joysfera/SDrive/HW/FUSES.GIF

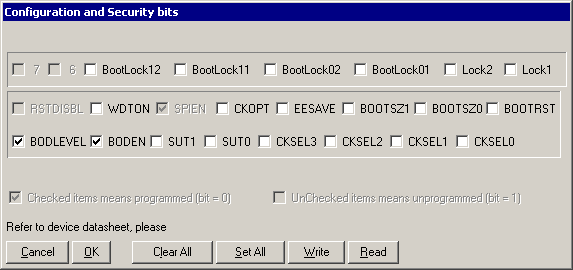
HW/FUSES.GIF
