joysfera/SDrive/HW/SDRIVE_AVR_PROGRAMMING_CABLE.PNG

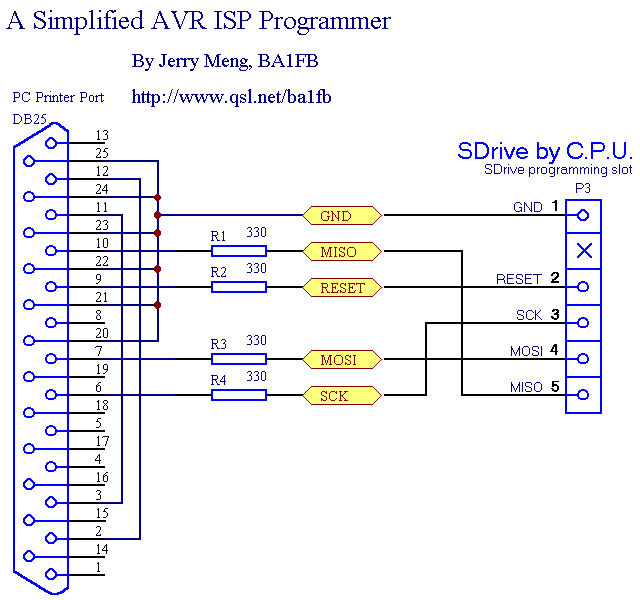
HW/SDRIVE_AVR_PROGRAMMING_CABLE.PNG
