joysfera/SDrive/HW/SILKSCREEN_PADS.PNG

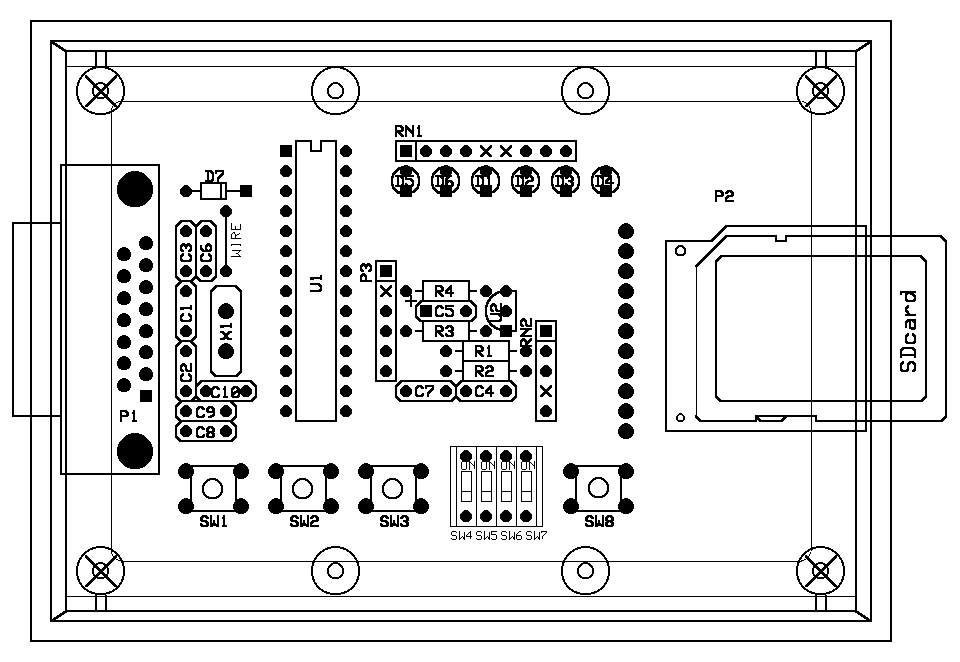
HW/SILKSCREEN_PADS.PNG
