joysfera/SDrive/HW/PCB_COMPONENTS.PNG

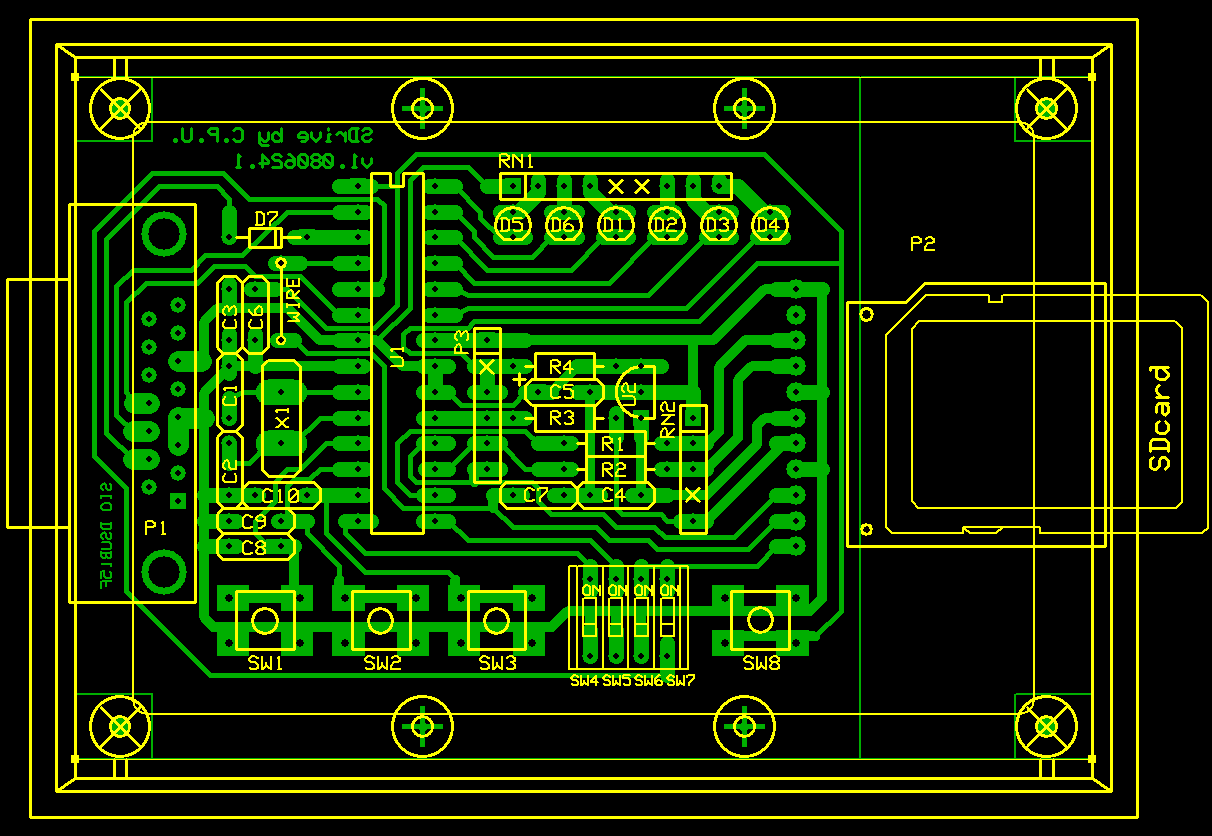
HW/PCB_COMPONENTS.PNG
