joysfera/SDrive/HW/PCB_COMPONENTS.PDF

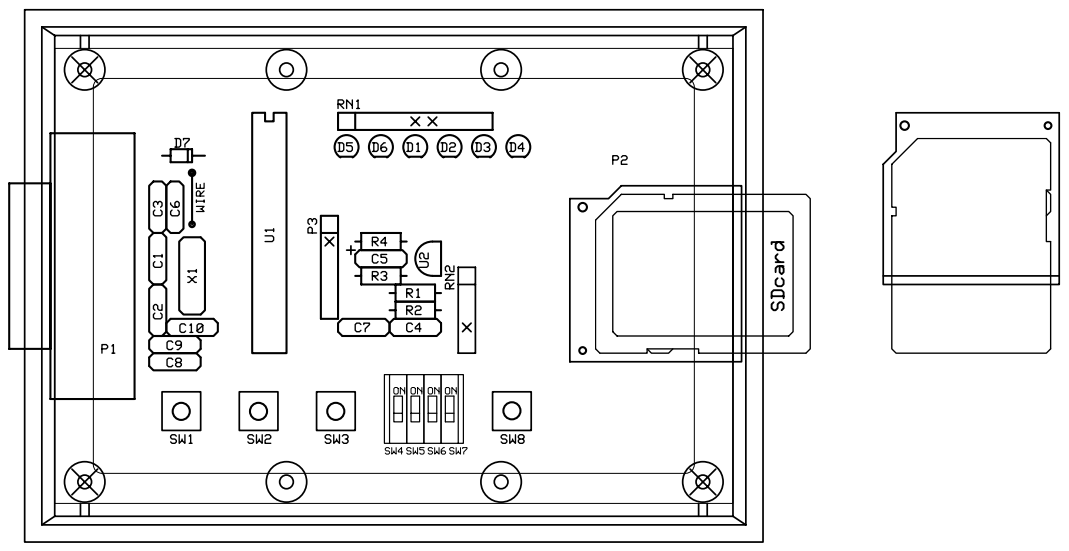
[picture p9: page 1]
