joysfera/SDrive/HW/ELEMENTS.PDF

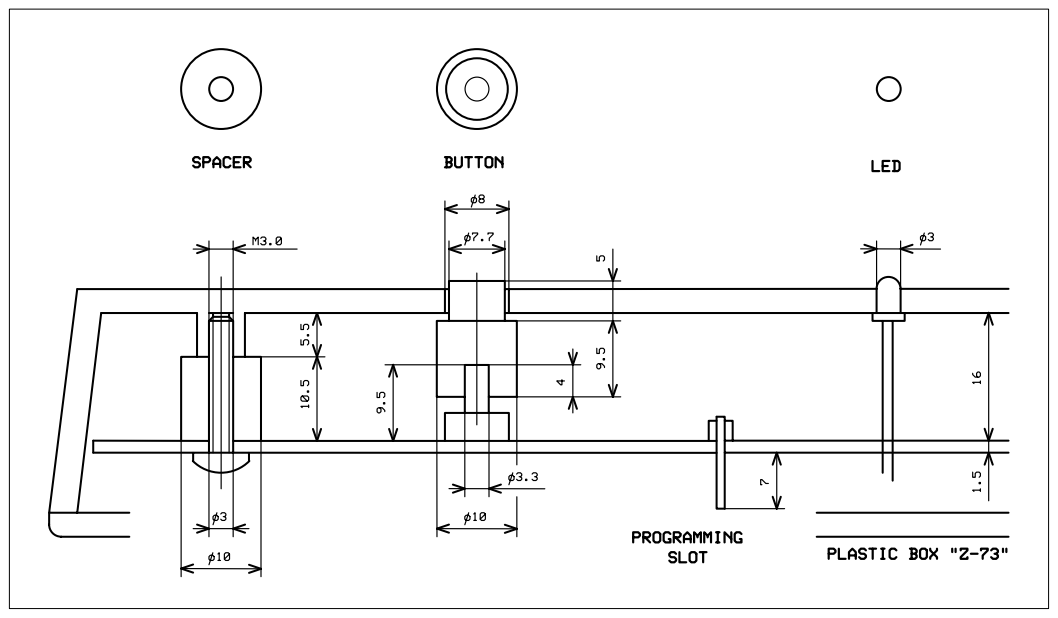
[picture p10: page 1]
