joysfera/SDrive/HW/PCB.PDF

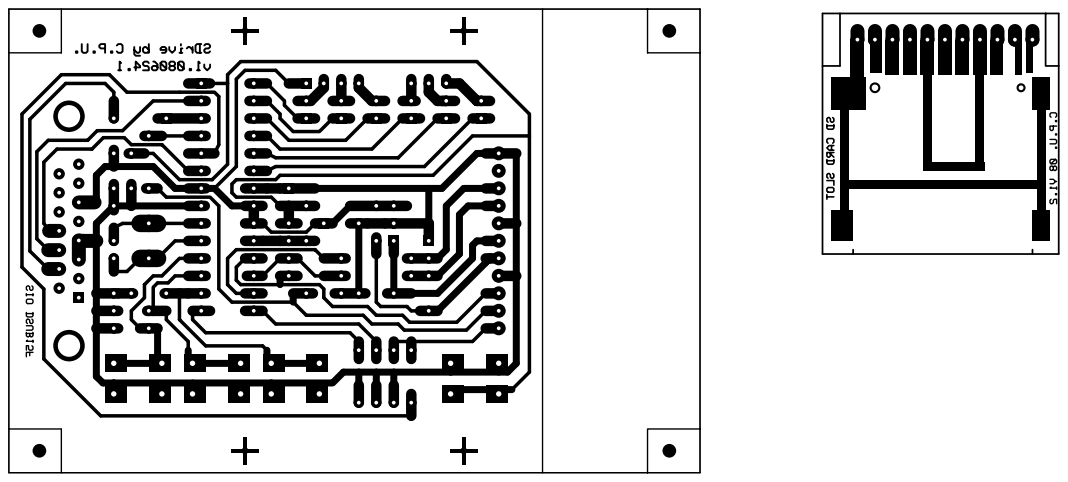
[picture p11: page 1]
