joysfera/SDrive/HW/PCB_NEGATIVE.PDF

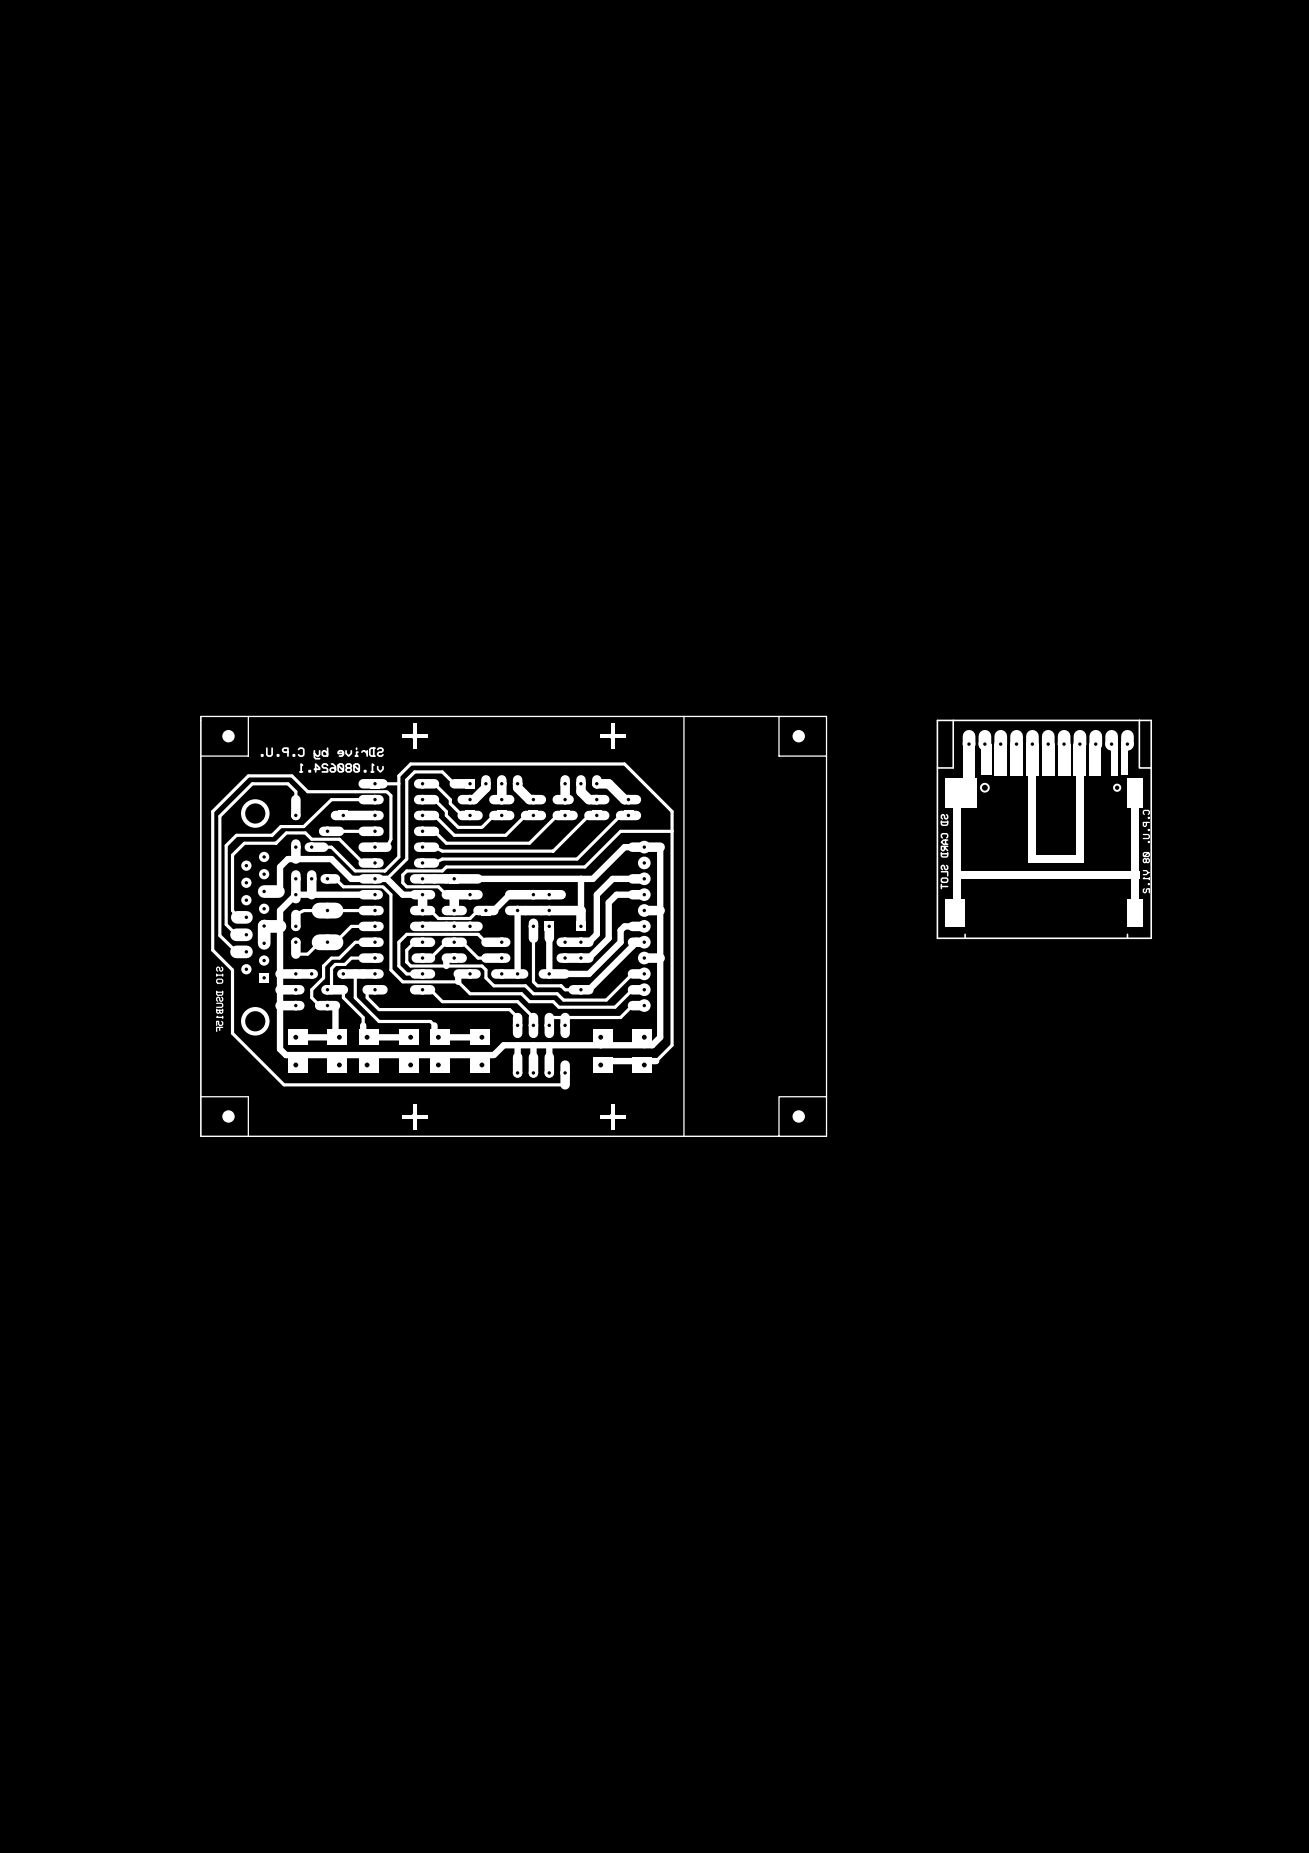
[picture p12: page 1]
