joysfera/SDrive/HW/SCHEME.PDF

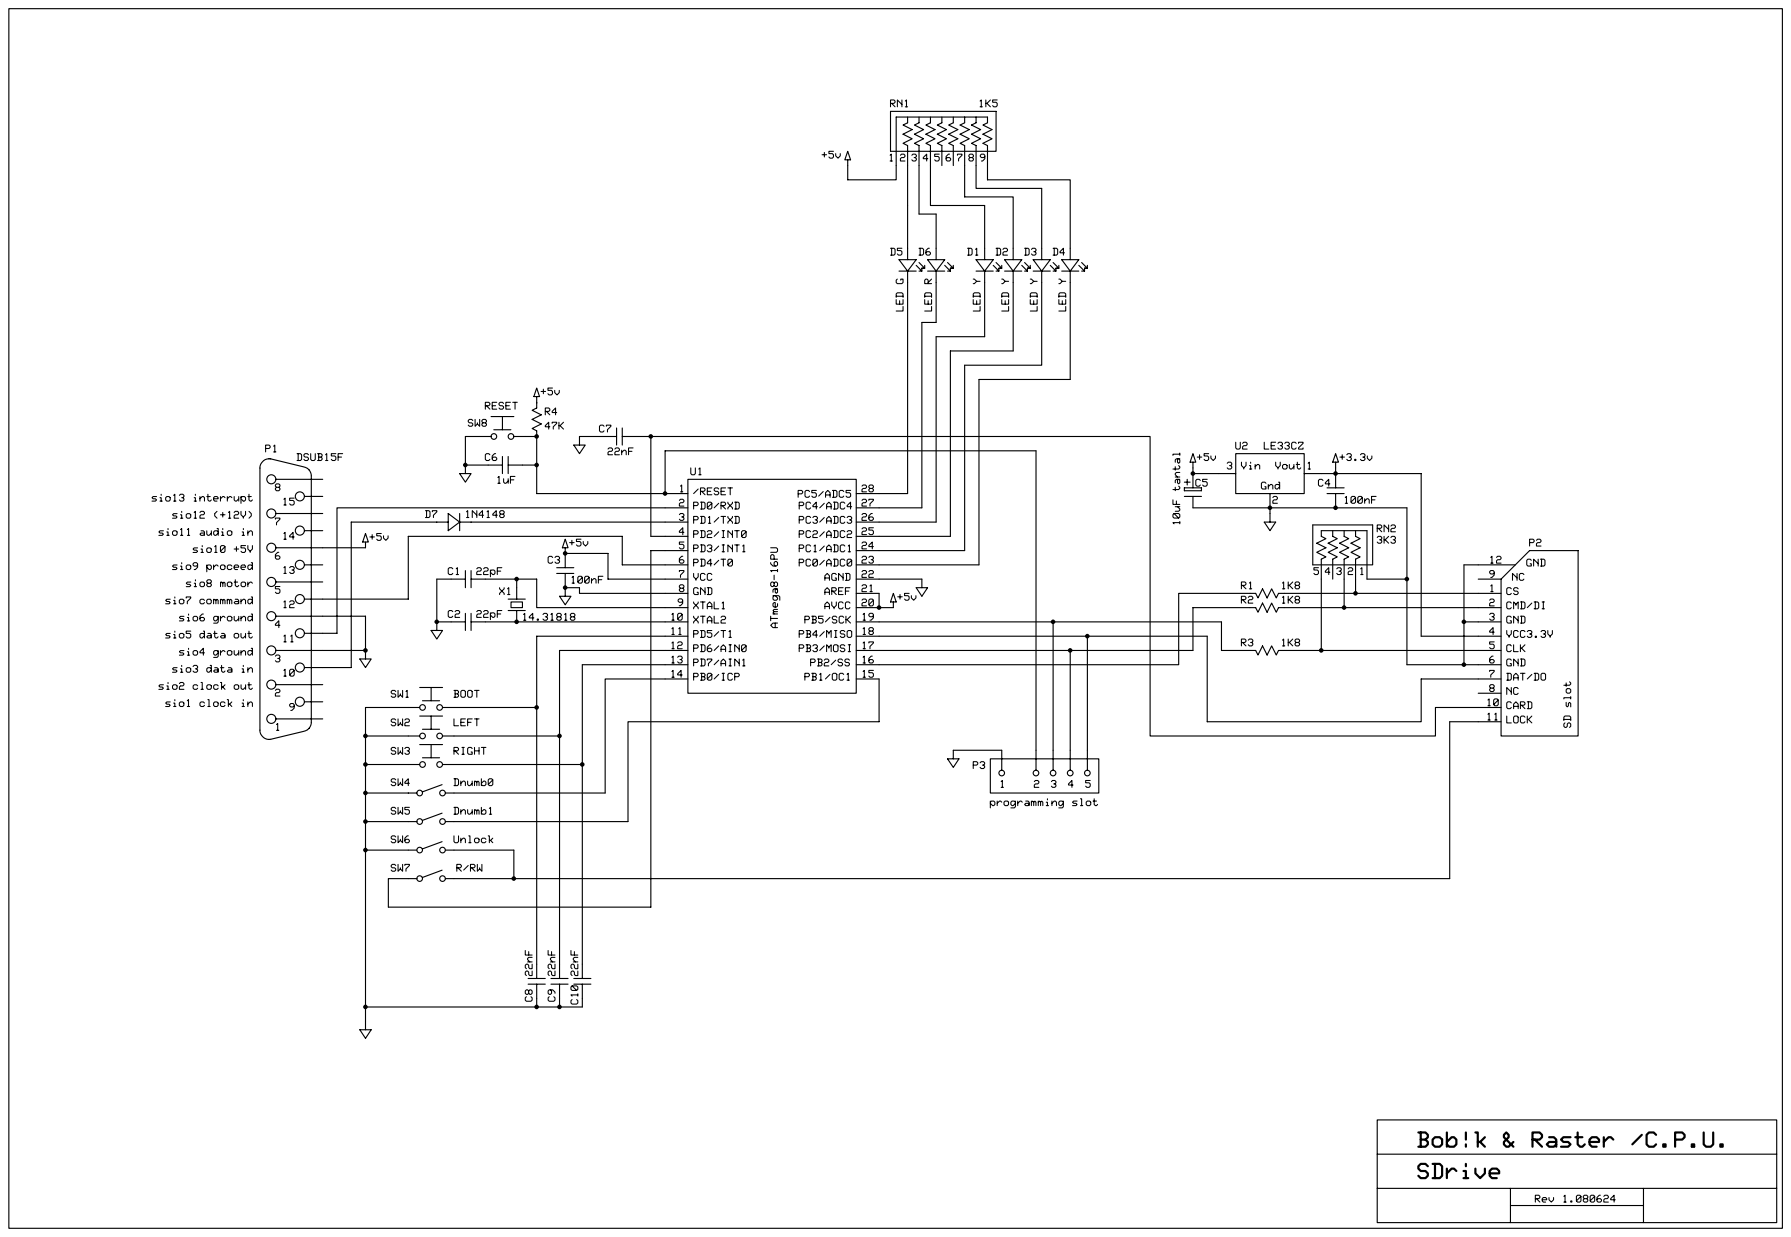
[picture p13: page 1]
