joysfera/SDrive/HW/SDRIVE_LABEL.PDF

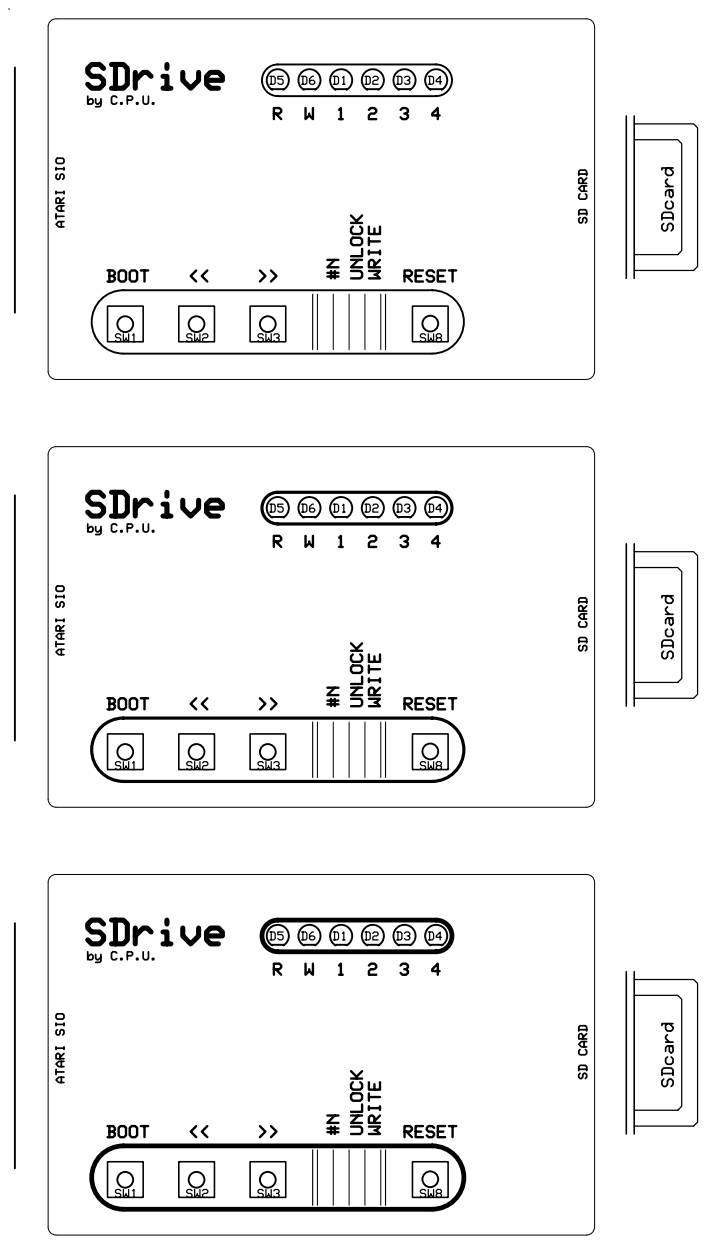
[picture p14: page 1]
