joysfera/SDrive/SDrive.c

//*****************************************************************************
// SDrive
// Bob!k & Raster, C.P.U., 2008-2012
//*****************************************************************************

#include <avr/io.h>			// include I/O definitions (port names, pin names, etc)
#include <avr/interrupt.h>	// include interrupt support
#include <avr/pgmspace.h>

#include <avr/eeprom.h>

#include "avrlibdefs.h"			// global AVRLIB defines
#include "avrlibtypes.h"		// global AVRLIB types definitions
#include "spi.h"		// include SPI interface functions
#include "mmc.h"		// include MMC card access functions
#include "fat.h"
#include "sboot.h"

#define DEBUG_RAM 		0	//0=off, 1=on

#define    TWOBYTESTOWORD(ptr)           *((u16*)(ptr))
#define    FOURBYTESTOLONG(ptr)           *((u32*)(ptr))


extern void Delay100usX(unsigned short delay);        //externi funkce
extern void Delay100us();
extern void Delay200us();
extern void Delay800us();
extern void Delay1000us();

//F_CPU = 14318180
//UBRR = (F_CPU/16/BAUD)-1
//BAUD = (F_CPU/16/(UBRR+1)
//Pokey_frq = 1789790
//BAUD = Pokey_frq/2/(AUDF+7)		//(16bit register)

#define US_POKEY_DIV_STANDARD	0x28		//#40  => 19040 bps
#define ATARI_SPEED_STANDARD	(US_POKEY_DIV_STANDARD+6)	//#46 (o sest vic)

#define US_POKEY_DIV_DEFAULT	0x06		//#6   => 68838 bps

#define US_POKEY_DIV_MAX		(255-6)		//pokeydiv 249 => avrspeed 255 (vic nemuze)

/*
#define SIOSPEED_MODES	9	//pocet fastsio_mode=0..8
#define US_POKEY_DIV_DEFAULT	US_POKEY_DIV_7
#define ATARI_SPEED_DEFAULT		ATARI_SPEED_7

//sio 1x standard
#define US_POKEY_DIV_STANDARD	0x28		//=> 19040 bps
#define ATARI_SPEED_STANDARD	46			// normal speed
//=46 => F_CPU/16/(46+1) = 19040

//sio2x
#define US_POKEY_DIV_2		0x10			//=> 38908 bps
#define ATARI_SPEED_2		22				// sio2x speed
//=22 => F_CPU/16/(22+1) = 38908

//Happy
#define US_POKEY_DIV_3		0x0a			//=> 52641 bps
#define ATARI_SPEED_3		16				// happy
//=16 => F_CPU/16/(16+1) = 52640

//Speedy
#define US_POKEY_DIV_4		0x09		//=> 55931 bps
#define ATARI_SPEED_4		15			// speedy TOTO FUNGUJE
//=15 => F_CPU/16/(15+1) = 55930

//sio3x
#define US_POKEY_DIV_5		0x08			//=> 59660 bps
#define ATARI_SPEED_5		14				// sio3x speed
//=14 => F_CPU/16/(14+1) = 59659

//sio 64000
#define US_POKEY_DIV_6		0x07			//=> 63921 bps
#define ATARI_SPEED_6		13				// sio3x speed
//=13 => F_CPU/16/(13+1) = 63920

// works great!
#define US_POKEY_DIV_7		0x06			//=> 68838 bps
#define ATARI_SPEED_7		12				// ULTRA speed - closest match for both systems (AVR,ATARI)
//=12 => F_CPU/16/(12+1) = 68837

//sio 75000
#define US_POKEY_DIV_8		0x05			//=> 74575 bps
#define ATARI_SPEED_8		11				// sio4x speed
//=11 => F_CPU/16/(11+1) = 74574
*/

#define FILE_ACCESS_READ	0
#define FILE_ACCESS_WRITE	1

// Aktivita
#define LED_GREEN_ON	cbi(PORTC,5)
#define LED_GREEN_OFF	sbi(PORTC,5)
// Zapis
#define LED_RED_ON		cbi(PORTC,4)
#define LED_RED_OFF		sbi(PORTC,4)

unsigned char mmc_sector_buffer[512];	// one SD sector
u32 n_actual_mmc_sector;
unsigned char n_actual_mmc_sector_needswrite;
unsigned char atari_sector_buffer[256];

#define FileFindBuffer (atari_sector_buffer+256-11)		//pri vyhledavani podle nazvu

struct GlobalSystemValues GS;
struct FileInfoStruct FileInfo;			//< file information for last file accessed

extern u32 debug_endofvariables;

#define send_ACK()	USART_Transmit_Byte('A');
#define send_NACK()	USART_Transmit_Byte('N');
#define send_CMPL()	USART_Transmit_Byte('C');
#define send_ERR()	USART_Transmit_Byte('E');

#define wait_cmd_HL() { while ( (inb(PIND) & (1<<PIND4)) ); }
#define wait_cmd_LH() { while ( !(inb(PIND) & (1<<PIND4)) ); }

#define CMD_STATE_H		(1<<PIND4)
#define CMD_STATE_L		0
#define get_cmd_H()		( inb(PIND) & (1<<PIND4) )
#define get_cmd_L()		( !(inb(PIND) & (1<<PIND4)) )
#define get_readonly()	( inb(PIND) & (1<<PIND3) )		//read only

#define read_key()		(inb(PIND)&0xe4)

unsigned char last_key;

unsigned char get_checksum(unsigned char* buffer, u16 len)
{
	u16 i;
	u08 sumo,sum;
	sum=sumo=0;
	for(i=0;i<len;i++)
	{
		sum+=buffer[i];
		if(sum<sumo) sum++;
		sumo = sum;
	}
	return sum;
}

/*
//pouziva se jen jednou v USART_Init, takze vlozena primo do teto funkce (uspora 10bytu)
void USART_Flush( void )
{
	unsigned char dummy;
	while ( UCSRA & (1<<RXC) ) dummy = UDR;
}
*/

void USART_Init( u08 value )
{
	/* Wait for empty transmit buffer */
	while ( !( UCSRA & (1<<UDRE)) ); //cekani

	/* Set baud rate */
//	UBRRH = (unsigned char)(baud>>8);
//	UBRRL = (unsigned char)(baud&0xff);
	UBRRH = 0;	//HB =0
	UBRRL = value;

	/* Set double speed flag */
	//	UCSRA = (1<<UDRE)|(1<<U2X); //double speed
	UCSRA = (1<<UDRE);

	/* Enable Receiver and Transmitter */
	UCSRB = (1<<RXEN)|(1<<TXEN);
	/* Set frame format: 8data, 1stop bit */
	UCSRC = (1<<URSEL)|(1<<UCSZ1)|(1<<UCSZ0);

	//void USART_Flush( void )
	{
	 unsigned char dummy;
	 while ( UCSRA & (1<<RXC) ) dummy = UDR;
	}
}

void USART_Transmit_Byte( unsigned char data )
{
	/* Wait for empty transmit buffer */
	while ( !( UCSRA & (1<<UDRE)) )	;

	/* Put data into buffer, sends the data */
	UDR = data;
}

unsigned char USART_Receive_Byte( void )
{
	/* Wait for data to be received */
	while ( !(UCSRA & (1<<RXC)) );

	/* Get and return received data from buffer */
	return UDR;
}

/*
//Bob rekl ze zapoznamkovat - nikde se nepouziva 25.1.2008
unsigned char USART_Is_Byte_Received( void )
{
	return (UCSRA & (1<<RXC))?1:0;
}
*/

void USART_Send_Buffer(unsigned char *buff, u16 len)
{
	while(len>0) { USART_Transmit_Byte(*buff++); len--; }
}

/*
void USART_Get_Buffer(unsigned char *buff, u16 len)
{
	while(len>0) { *buff++=USART_Receive_Byte(); len--; }
}
*/

u08 USART_Get_Buffer_And_Check(unsigned char *buff, u16 len, u08 cmd_state)
{
	//prebere len bytu + 1 byte checksum
	//pokud se behem nacitani zmeni cmd_state => return 0x01
	//pokud se behem nacitacni zmeni getkey => return 0x02
	//pak zkontroluje checksum
	//pokud nesouhlasi checksum, return 0x80
	//pokud vse ok, return 0x00
	u08 *ptr;
	u16 n;
	u08 b;
	ptr=buff;
	n=len;
	while(1)
	{ 
		// Wait for data to be received
		do
		{
			//pokud by prisel command L nebo stisknuta klavesa, prerusi prijem
			if ( get_cmd_H()!=cmd_state ) return 0x01;
			if ( read_key()!=last_key ) return 0x02;
		} while ( !(UCSRA & (1<<RXC)) );
		// Get and return received data from buffer
		//return UDR;
		b=UDR;
		if (!n)
		{
			//v b je checksum (n+1 byte)
			if ( b!=get_checksum(buff,len) ) return 0x80;	//chyba checksumu
			return 0x00; //ok
		}
		*ptr++=b;
		n--;
	}
}

u08 USART_Get_buffer_and_check_and_send_ACK_or_NACK(unsigned char *buff, u16 len)
{
	unsigned char err;
	//tady pred ctenim zadna pauza

	err = USART_Get_Buffer_And_Check(buff,len,CMD_STATE_H);
	//vraci 0 kdyz ok, !=0 kdyz chyba

	Delay1000us();	//t4
	if(err)
	{
		send_NACK();
		return 0xff; //kdyz nesouhlasi checksum
	}
	send_ACK();
//	Delay300us(); //po ACKu je pauza (250usec az 255s), protoze se pak posila CMPL nebo ERR
	// ^ tahle pauza se dela pred CMPL nebo ERR
	return 0;	//kdyz je ok vraci 0
}

/*
u08 USART_Get_atari_sector_buffer_and_check_and_send_ACK_or_NACK(u16 len)
{
	USART_Get_buffer_and_check_and_send_ACK_or_NACK(atari_sector_buffer,len);
}
*/
#define USART_Get_atari_sector_buffer_and_check_and_send_ACK_or_NACK(len)	USART_Get_buffer_and_check_and_send_ACK_or_NACK(atari_sector_buffer,len)


void USART_Send_cmpl_and_atari_sector_buffer_and_check_sum(unsigned short len)
{
	u08 check_sum;

	//	Delay300us();	//po ACKu pred CMPL pauza 250us - 255sec
	//	Delay300us();	//po ACKu pred CMPL pauza 250us - 255sec
	//Kdyz bylo jen 300us tak nefungovalo
	Delay800us();	//t5
	send_CMPL();
	//	Delay1000us();	//S timhle to bylo doposud (a nefunguje pod Qmegem3 Ultraspeed vubec)
	//	Delay100us(); 		//Pokusne kratsi pauza
						//(tato fce se pouziva se i u read SpeedIndex 3F,
						// coz s delsi pauzou nefunguje (pod Qmegem3 fast)
	//Delay800us();	//t6
	Delay200us();	//<--pouziva se i u commandu 3F

	USART_Send_Buffer(atari_sector_buffer,len);
	check_sum = get_checksum(atari_sector_buffer,len);
	USART_Transmit_Byte(check_sum);
}

u08 mmcWriteCached(unsigned char force);
void mmcWriteCachedFlush();

void mmcReadCached(u32 sector)
{
	if(sector==n_actual_mmc_sector) return;

	u08 ret,retry;
	//predtim nez nacte jiny, musi ulozit soucasny
	mmcWriteCachedFlush();
	//az ted nacte novy
	retry=0; //zkusi to maximalne 256x
	do
	{
		ret = mmcRead(sector);	//vraci 0 kdyz ok
		retry--;
	} while (ret && retry);
	while(ret); //a pokud se vubec nepovedlo, tady zustane zablokovany cely SDrive!
	n_actual_mmc_sector=sector;
}

u08 mmcWriteCached(unsigned char force)
{
	if ( get_readonly() ) return 0xff; //zakazany zapis
	LED_RED_ON;
	if (force)
	{
		u08 ret,retry;
		retry=16; //zkusi to maximalne 16x
		do
		{
			ret = mmcWrite(n_actual_mmc_sector); //vraci 0 kdyz ok
			retry--;
		} while (ret && retry);
		while(ret); //a pokud se vubec nepovedlo, tady zustane zablokovany cely SDrive!
		n_actual_mmc_sector_needswrite = 0;
		LED_RED_OFF;
	}
	else
	{
		n_actual_mmc_sector_needswrite=1;
	}
	return 0; //vraci 0 kdyz ok
}

void mmcWriteCachedFlush()
{
	if (n_actual_mmc_sector_needswrite)
	{
	 while (mmcWriteCached(1)); //pokud je zakazany zapis, tady zustane zablokovany cely SDrive!
	 							//do okamziku, nez ten zapis nebude povolen (visi mu neco v cache)
	}
}


unsigned short getClusterN(unsigned short ncluster)
{
	if(ncluster<FileInfo.vDisk.ncluster)
	{
		FileInfo.vDisk.current_cluster=FileInfo.vDisk.start_cluster;
		FileInfo.vDisk.ncluster=0;
	}

	while(FileInfo.vDisk.ncluster!=ncluster)
	{
		FileInfo.vDisk.current_cluster=nextCluster(FileInfo.vDisk.current_cluster);
		FileInfo.vDisk.ncluster++;
	}

	return (FileInfo.vDisk.current_cluster&0xFFFF);
}


unsigned short faccess_offset(char mode, unsigned long offset_start, unsigned short ncount)
{
	unsigned short j;
	unsigned long offset=offset_start;
	unsigned long end_of_file;
	unsigned long ncluster, nsector, current_sector;
	unsigned long bytespercluster=((u32)SectorsPerCluster)*((u32)BytesPerSector);

	if(offset_start>=FileInfo.vDisk.size)
		return 0;

	end_of_file = (FileInfo.vDisk.size - offset_start);

	ncluster = offset/bytespercluster;
	offset-=ncluster*bytespercluster;

	nsector = offset/((u32)BytesPerSector);
	offset-=nsector*((u32)BytesPerSector);

	getClusterN(ncluster);

	current_sector = fatClustToSect(FileInfo.vDisk.current_cluster) + nsector;
	mmcReadCached(current_sector);

	for(j=0;j<ncount;j++,offset++)
	{
			if(offset>=((u32)BytesPerSector) )
			{
				if(mode==FILE_ACCESS_WRITE && mmcWriteCached(0))
					return 0;

				offset=0;
				nsector++;

				if(nsector>=((u32)SectorsPerCluster) )
				{
					nsector=0;
					ncluster++;
					getClusterN(ncluster);
				}

				current_sector = fatClustToSect(FileInfo.vDisk.current_cluster) + nsector;
				mmcReadCached(current_sector);
			}

		if(!end_of_file)
			break; //return (j&0xFFFF);

		if(mode==FILE_ACCESS_WRITE)
			mmc_sector_buffer[offset]=atari_sector_buffer[j]; //SDsektor<-atarisektor
		else
			atari_sector_buffer[j]=mmc_sector_buffer[offset]; //atarisektor<-SDsektor

		end_of_file--;

	}
	

	if(mode==FILE_ACCESS_WRITE && mmcWriteCached(0))
		return 0;

	return (j&0xFFFF);
}


// DISPLAY

#define init_display()		{ PORTC=(inb(PINC)&0xc0)|0x3f; }		//zhasne vsechny kontrolky

void set_display(unsigned char n)
{
	//PORTC=(inb(PINC)&0xe0)|(0x1f ^ (1<<(4-n)) );
	//PORTC=(inb(PINC)&0xf0)|( (n>0)? (0x0f ^ (1<<(4-n)) ) : 0);
	u08 v;
	v=inb(PINC)&0xf0;
	if (n>0) v|=(0x0f ^ (1<<(4-n)) );  //pro bootD0: sviti vsechny 4 zlute diody
	PORTC=v;
}

//#define full_display()		{ PORTC=(inb(PINC)&0xc0)|0x00; }


//prog_uchar system_atr_name[]={"SDRIVE  .ATR"};
// =pgm_read_byte_near(&system_atr_name[idx]);
//uint8_t EEMEM system_atr_name[]={"SDRIVE  ATR"};
// =eeprom_read_byte(&system_atr_name[idx]);
//
//uint8_t EEMEM system_info[]="SDrive01 20081012 Bob!k & Raster, C.P.U.";	//SDriveVersion info
uint8_t EEMEM   system_info[]="SDrive02 20120901 Bob!k & Raster, C.P.U.";	//SDriveVersion info

//                                 VVYYYYMMDD
//                                 VV cislo nove oficialne vydane verze, meni se jen pri vydani noveho oficialniho firmware
//									  s rozsirenymi/zmenenymi funkcemi zpetne nekompatibilni
//									  rostouci posloupnost 01 .. 09 0A 0B .. 0Z .. 0a 0b .. 0y 0z 10 11 ..... zz

//nasledujici parametry se daji modifiovat pres EEPROM configure
//                              |filenameext|
uint8_t EEMEM system_atr_name[]="SDRIVE  ATR";  //8+3 zamerne deklarovano za system_info,aby bylo pripadne v dosahu pres get status
//
uint8_t EEMEM system_fastsio_pokeydiv_default=US_POKEY_DIV_DEFAULT;

/*
1) 720*128=92160	   (  90,000KB)
2) 1040*128=133120         ( 130,000KB)
3) 3*128+717*256=183936    ( 179,625KB)
4) 3*128+1437*256=368256   ( 359,625KB)
5) 3*128+2877*256=736896   ( 719,625KB)
6) 3*128+5757*256=1474176  (1439,625KB)
7) 3*128+11517*256=2948736 (2879,625KB)
8) 3*128+...
*/
#define IMSIZE1	92160
#define IMSIZE2	133120
#define IMSIZE3	183936
#define IMSIZE4	368256
#define IMSIZE5	736896
#define	IMSIZE6	1474176
#define IMSIZE7	2948736
#define IMSIZES 7

uint8_t EEMEM system_percomtable[]= {
	0x28,0x01,0x00,0x12,0x00,0x00,0x00,0x80, IMSIZE1&0xff,(IMSIZE1>>8)&0xff,(IMSIZE1>>16)&0xff,(IMSIZE1>>24)&0xff,
	0x28,0x01,0x00,0x1A,0x00,0x04,0x00,0x80, IMSIZE2&0xff,(IMSIZE2>>8)&0xff,(IMSIZE2>>16)&0xff,(IMSIZE2>>24)&0xff,
	0x28,0x01,0x00,0x12,0x00,0x04,0x01,0x00, IMSIZE3&0xff,(IMSIZE3>>8)&0xff,(IMSIZE3>>16)&0xff,(IMSIZE3>>24)&0xff,
	0x28,0x01,0x00,0x12,0x01,0x04,0x01,0x00, IMSIZE4&0xff,(IMSIZE4>>8)&0xff,(IMSIZE4>>16)&0xff,(IMSIZE4>>24)&0xff,
	0x50,0x01,0x00,0x12,0x01,0x04,0x01,0x00, IMSIZE5&0xff,(IMSIZE5>>8)&0xff,(IMSIZE5>>16)&0xff,(IMSIZE5>>24)&0xff,
	0x50,0x01,0x00,0x24,0x01,0x04,0x01,0x00, IMSIZE6&0xff,(IMSIZE6>>8)&0xff,(IMSIZE6>>16)&0xff,(IMSIZE6>>24)&0xff,
	0x50,0x01,0x00,0x48,0x01,0x04,0x01,0x00, IMSIZE7&0xff,(IMSIZE7>>8)&0xff,(IMSIZE7>>16)&0xff,(IMSIZE7>>24)&0xff,
	0x01,0x01,0x00,0x00,0x00,0x04,0x01,0x00, 0x00,0x00,0x00,0x00
	};



#define DEVICESNUM	5	//	//D0:-D4:
static virtual_disk_t vDisk[DEVICESNUM];

virtual_disk_t* GetvDiskPtr(u08 devicenum)
{
 return &vDisk[devicenum];
}

void Clear_atari_sector_buffer(u16 len)
{
	//Maze atari_sector_buffer
	u08 *ptr;
	ptr=atari_sector_buffer;
	do { *ptr++=0; len--; } while (len);
}

//#define Clear_atari_sector_buffer_256()	Clear_atari_sector_buffer(256)

void Clear_atari_sector_buffer_256()
{
	Clear_atari_sector_buffer(256); //0 => maze 256 bytu
}

void PutDecimalNumberToAtariSectorBuffer(unsigned char num, unsigned char pos)
{
	u08 *ptr;
	ptr = (atari_sector_buffer+pos);
	*ptr++=0x30|(num/10);
	*ptr=0x30|(num%10);
}

struct SDriveParameters
{
	u08 p0;
	u08 p1;
	u08 p2;
	u08 p3;
	u32 p4_5_6_7;
};

//sdrparams je nadeklarovano uvnitr main() (hned na zacatku)
#define actual_drive_number sdrparams.p0
#define fastsio_active		sdrparams.p1
#define fastsio_pokeydiv	sdrparams.p2
#define bootloader_relocation sdrparams.p3
#define extraSDcommands_readwritesectornumber	sdrparams.p4_5_6_7


//----- Begin Code ------------------------------------------------------------
int main(void) __attribute__ ((noreturn));	//size optimization 8122->8098 bytes
int main(void)
{
	unsigned char command[5];
	unsigned char last_used_virtual_drive;

	//Parameters
	struct SDriveParameters sdrparams;

#if DEBUG_RAM
	{
		//naplni pamet 0x55kama
		unsigned char *p;
		for(p=0x60; p<(0x045f-64); p++) *p=0x55;
	}

	debug_endofvariables=0xaaaaaaaa;	//posledni promenna
#endif

/*
	sbi(DDRC,0); // LED_pin out;
	sbi(DDRC,1); // LED_pin out;
	sbi(DDRC,2); // LED_pin out;
	sbi(DDRC,3); // LED_pin out;
	sbi(DDRC,4); // LED_pin out;
	sbi(DDRC,5); // LED_pin out;
*/
	DDRC |= 0x3f;	//00111111

	cbi(DDRB,0); // KEY_pin input
	cbi(DDRB,1); // KEY_pin input

/*
	cbi(DDRD,2); // KEY_pin input
	cbi(DDRD,3); // KEY_pin input
	cbi(DDRD,4); // KEY_pin input (karta)
	cbi(DDRD,5); // KEY_pin input
	cbi(DDRD,6); // KEY_pin input
	cbi(DDRD,7); // KEY_pin input
*/
	DDRD &= ~0xfc;		//11111100

	sbi(PORTB,0); // pull-up
	sbi(PORTB,1); // pull-up

/*
	sbi(PORTD,2); // pull-up
	sbi(PORTD,3); // pull-up
	sbi(PORTD,4); // pull-up (karta)
	sbi(PORTD,5); // pull-up
	sbi(PORTD,6); // pull-up
	sbi(PORTD,7); // pull-up
*/
	PORTD |= 0xfc;		//11111100


SD_CARD_EJECTED:

	last_key=0;
	last_used_virtual_drive=0;	//inicializace
	fastsio_active=0;
	bootloader_relocation=0;
	//actual_drive_number=0;	//nastavovano kousek dal (za SET_BOOT_DRIVE)
	FileInfo.percomstate=0;	//inicializace
	//fastsio_pokeydiv=US_POKEY_DIV_DEFAULT;		//default fastsio
	fastsio_pokeydiv=eeprom_read_byte(&system_fastsio_pokeydiv_default); //definovano v EEPROM

	init_display();

	USART_Init(ATARI_SPEED_STANDARD);

	LED_GREEN_ON;	// LED on

	//CEKACI SMYCKA!!!
	while (inb(PIND)&0x04); //cekani az zasune nejakou kartu

	//pozor, v tomto okamziku nesmi byt nacacheovan zadny sektor
	//pro zapis, protoze init karty inicializuje i mmc_sector atd.!!!
	do
	{
		mmcInit();
	}
	while(mmcReset());	//dokud nenulove, tak smycka (return 0 => ok!)
	//n_actual_mmc_sector=0xFFFFFFFF; //presunuto do mmcReset

	// set SPI speed on maximum (F_CPU/2)
	sbi(SPSR, SPI2X);
	cbi(SPCR, SPR1);
	cbi(SPCR, SPR0);

	{
	 u08 i;
	 for(i=0; i<DEVICESNUM; i++) GetvDiskPtr(i)->flags=0;	//vDisk[i].flags=0;
	}
	FileInfo.vDisk.flags=0;		//special_xex_loader=0;

SET_BOOT_DRIVE:

	actual_drive_number=0;	//pro bootovani z jednotky vD0:

SET_SDRIVEATR_TO_D0:	//pro nastaveni SDRIVE.ATR do vD0: bez zmeny actual_drive_number !

	//uschovani aktualne vybraneho drive (po opakovanem stlaceni Boot tlacitka)
	//protoze obsah vD0: bude menit
	if ( last_used_virtual_drive != 0 )
	{
		//chce pracovat s jinym vDx nez se pracovalo posledne
		unsigned char i;
		unsigned char *p1;
		unsigned char *p2;
		p2=((unsigned char *)&FileInfo.vDisk);
		if ( last_used_virtual_drive < DEVICESNUM )
		{
		 p1=((unsigned char *)&vDisk[last_used_virtual_drive]);
		 // vDisk[last_used_virtual_drive] <- vDisk
		 for(i=0; i<sizeof(virtual_disk_t); i++) p1[i]=p2[i];
		}
		last_used_virtual_drive=0; //bude menit vD0:
	}

	if ( !fatInit() ) //Inicializace FATky
	{
		//ta karta co je tam zastrcena neni zadny
		//filesystem co umime
		//takze zhasneme zelenou diodu
		LED_GREEN_OFF;	// LED OFF
		//a pocka az vytahnes kartu ven
		while (!(inb(PIND)&0x04)); //cekani az vysune kartu ven
		//a jde cekat na jinou
		goto SD_CARD_EJECTED;
	}

	//Vyhledani a nastaveni image SDRIVE.ATR do vD0:
	{
		unsigned short i;
		unsigned char m;

		i=0;
		while( fatGetDirEntry(i,0) )
		{
			for(m=0;m<11;m++)	//8+3
			{
				if(atari_sector_buffer[m]!=eeprom_read_byte(&system_atr_name[m]))
				{
					//odlisny znak
					goto find_sdrive_atr_next_entry;
				}
			}

			//Slava, nasel SDRIVE.ATR
			FileInfo.vDisk.current_cluster=FileInfo.vDisk.start_cluster;
			FileInfo.vDisk.ncluster=0;
			//FileInfo.vDisk.file_index = i; //dela se uvnitr fatGetDirEntry

			faccess_offset(FILE_ACCESS_READ,0,16); //ATR hlavicka vzdy

			FileInfo.vDisk.flags=FLAGS_DRIVEON;
			if ( (atari_sector_buffer[4]|atari_sector_buffer[5])==0x01 )
				FileInfo.vDisk.flags|=FLAGS_ATRDOUBLESECTORS;

			{
				unsigned long compute;
				unsigned long tmp;

				compute = FileInfo.vDisk.size - 16;		//je to vzdy ATR
				tmp = (FileInfo.vDisk.flags & FLAGS_ATRDOUBLESECTORS)? 0x100:0x80;
				compute /=tmp;

				if(compute>720) FileInfo.vDisk.flags|=FLAGS_ATRMEDIUMSIZE;
			}
			goto find_sdrive_atr_finished;
			//
find_sdrive_atr_next_entry:
			i++;
		} //end while

		//nenasel SDRIVE.ATR
		FileInfo.vDisk.flags=0; //ve vD0: neni aktivni disk
		//takze nastavi jednotku dle cisla SDrive (1-4)
		if (actual_drive_number==0)
		{
		 actual_drive_number=(unsigned char)4-((unsigned char)(inb(PINB))&0x03);
		}
	}
find_sdrive_atr_finished:

	set_display(actual_drive_number);

/////////////////////

	for(;;)
	{
ST_IDLE:

		LED_GREEN_OFF;	// LED OFF

//		if (debug_endofvariables!=0xaaaaaaaa) set_display(4); //DEBUG!!!

		{
		 unsigned long autowritecounter;
autowritecounter_reset:
		 autowritecounter=0;
		 while( get_cmd_H() )	//dokud je Atari signal command na H
		 {
			//tak bude zkoumat klavesnici

			//buttons
			unsigned char actual_key;

			//read key				bit
			//PD7 .. RIGHT			0x80
			//PD6 .. LEFT			0x40
			//PD5 .. BOOT			0x20		
			//PD4
			//PD3 .. WRITE ENABLE 	0x08
			//PD2 .. CARD INSERTED	0x04
			//PD1
			//PD0
			actual_key = read_key();		//(inb(PIND)&0xe4)
			if(actual_key != last_key)
			{
				if (inb(PIND)&0x04) goto SD_CARD_EJECTED;
				//nyni je bit 0x04 vzdy 0 , protoze karta je vlozena
				switch(actual_key)	//&0xfe)
				{
					case 0xc0: //0x20^0xe0: //BOOT KEY
						//actual_drive_number=0;
						goto SET_BOOT_DRIVE;
						break;
					case 0xa0: //0x40^0xe0: //LEFT
						if(actual_drive_number>1)
							actual_drive_number--;
						else
							actual_drive_number=4;
						break;
					case 0x60: //0x80^0xe0: //RIGHT
						if(actual_drive_number<4)
							actual_drive_number++;
						else
							actual_drive_number=1;
						break;
				}
				set_display(actual_drive_number);
				last_key = actual_key;
				Delay100usX(500); //pauza 50ms = 0.05s (kvuli tlacitkum)
			}
			if (autowritecounter>1700000)
			{
				//  100'000 nebylo temer poznat
				//1'000'000 odpovida cca 1.75 sekundam
				//2'000'000 odpovida cca 3.5 sekundam
				//=>1s = 571428
				//1'700'000 odpovida cca 3 sekundam
			 	mmcWriteCachedFlush(); //pokud ceka nejaky sektor na zapis, zapise ho
				//goto autowritecounter_reset;
				autowritecounter=0;
			}
			else
			 autowritecounter++;
		 } //while
		}

		//Nacitani command frame
		{
			u08 err;
			err=USART_Get_Buffer_And_Check(command,4,CMD_STATE_L);

			//pokud je duvodem zmena cmd na H, nemusi cekat na wait_cmd_LH()
			//if (err&0x01) goto change_sio_speed; //zvedl se cmd na H, ihned jde menit rychlost

			Delay800us();	//t1 (650-950us) (Bez tehle pauzy to cele nefunguje!!!)
			wait_cmd_LH();	//ceka az se zvedne signal command na H
			Delay100us();	//T2=100   (po zvednuti command a pred ACKem)

			if(err)
			{
				//bylo duvodem klepnuti do klavesnice?
				if (err&0x02) goto ST_IDLE; //klepnul do klavesnice, takze nebude menit rychlost

				if (fastsio_pokeydiv!=US_POKEY_DIV_STANDARD)
				{
					//prehodi ze standard na fast nebo naopak
					fastsio_active=!fastsio_active;
				}

change_sio_speed_by_fastsio_active:
				{
				 u08 as;
				 as=ATARI_SPEED_STANDARD;	//default speed
				 if (fastsio_active) as=fastsio_pokeydiv+6;		//vzdy o 6 vic

				 USART_Init(as);
				}
				goto ST_IDLE;
			}
		}

		if( command[0]>=0x31 && command[0]<(0x30+DEVICESNUM) ) //D1: az D4: (ano, az od D1: !!!)
		{
			// dostupne "z venci" je jen D1: az D4: (pres 0x31 az 0x34)
			// ale pres zarizeni SDrive (0x71 az 0x74 podle zvoleneho cisla sdrive number)
			// se da pristupovat vzdy primo k vD0:

		   	// DISKETOVE OPERACE D0: az D4:
		  	unsigned char virtual_drive_number;

			if( command[0] == (unsigned char)0x31+3-((unsigned char)(inb(PINB))&0x03) )
			{
				//chce cist z drive Dx (D1: az D4:) ktere je prehazovaci
			    virtual_drive_number = actual_drive_number;
			}
			else
			if ( command[0] == (unsigned char)0x30+actual_drive_number )
			{
				//chce cist z drive Dx (D0: az D4:) ktery je prehozen s drive number
				virtual_drive_number = 4-((unsigned char)(inb(PINB))&0x03);
			}
			else
			{
				//chce cist z nektereho jineho Dx:
disk_operations_direct_d0_d4:
				virtual_drive_number = command[0]&0xf;
			}

			if ( last_used_virtual_drive != virtual_drive_number )
			{
				//chce pracovat s jinym vDx nez se pracovalo posledne
				unsigned char i;
				unsigned char *p1;
				unsigned char *p2;
				if ( last_used_virtual_drive < DEVICESNUM )
				{
				 p2=((unsigned char *)&FileInfo.vDisk);
				 p1=((unsigned char *)&vDisk[last_used_virtual_drive]);
				 // vDisk[last_used_virtual_drive] <- vDisk
				 //for(i=0; i<sizeof(virtual_disk_t); i++) p1[i]=p2[i];
				 //i=sizeof(virtual_disk_t); do { *p1++=*p2++; i--; } while(i);
				 for(i=0; i<sizeof(virtual_disk_t); i++) *p1++=*p2++;
				}
				p2=((unsigned char *)&FileInfo.vDisk);
				p1=((unsigned char *)&vDisk[virtual_drive_number]);
				// vDisk <- vDisk[virtual_drive_number]
				//for(i=0; i<sizeof(virtual_disk_t); i++) p2[i]=p1[i];
				//i=sizeof(virtual_disk_t); do { *p2++=*p1++; i--; } while(i);
				for(i=0; i<sizeof(virtual_disk_t); i++) *p2++=*p1++;
				//zmena last_used_virtual_drive
				last_used_virtual_drive=virtual_drive_number; //zmena
			}

			if (!(FileInfo.vDisk.flags & FLAGS_DRIVEON))
			{
				//do daneho Dx neni vlozen disk
				goto ST_IDLE;
			}

			//LED_GREEN_ON;	// LED on

			//pro cokoli jineho nez 0x53 (get status) nuluje FLAGS_WRITEERROR
			if (command[1]!=0x53) FileInfo.vDisk.flags &= (~FLAGS_WRITEERROR); //vynuluje FLAGS_WRITEERROR bit

			//formatovaci povely zpracovava v predsunu tady kvuli ACK/NACK
			switch(command[1])
			{
			case 0x21:	// format single + PERCOM
				// 	Single for 810 and stock 1050 or as defined by CMD $4F for upgraded drives (Speedy, Happy, HDI, Black Box, XF 551).
				//Returns 128 bytes (SD) or 256 bytes (DD) after format. Format ok requires that the first two bytes are $FF. It is said to return bad sector list (never seen one).

			   { //zacatek sekce pres dva case, 0x21,0x22
			    u08 formaterror;

				{
				 u32 singlesize;
				 singlesize = (u32)92160;
				 if ( !(FileInfo.vDisk.flags & FLAGS_XFDTYPE) ) singlesize+=(u32)16; //je to ATRko

				 if (   ( FileInfo.percomstate==3 ) //snazil se zapsat neodpovidajici percom
					|| ( (FileInfo.percomstate==0) && (FileInfo.vDisk.size!=singlesize) ) //neni single disketa
				   )
				 {
					goto Send_NACK_and_set_FLAGS_WRITEERROR_and_ST_IDLE;
				 }
				}

				{
					unsigned short i,size;
					if ( FileInfo.percomstate == 2)
					{
						size=256;
					}
					else
					{
format_medium:
						size=128;
					}

					FileInfo.percomstate=0; //po prvnim formatu pozbyva percom ucinnost

					//XEX formatovat nelze
					if (FileInfo.vDisk.flags & (FLAGS_XEXLOADER | FLAGS_READONLY))
					{
						goto Send_NACK_and_set_FLAGS_WRITEERROR_and_ST_IDLE;
					}

					//OK, bude se formatovat
					send_ACK();

					formaterror=0;

					{
					 //vynuluje formatovany soubor
					 Clear_atari_sector_buffer_256();
					 {
					  unsigned long maz,psize;
					  maz=0;
					  if ( !(FileInfo.vDisk.flags & FLAGS_XFDTYPE) ) maz+=16;
					  while( (psize=(FileInfo.vDisk.size-maz))>0 )
					  {
					   if (psize>256) psize=256;
					   if (!faccess_offset(FILE_ACCESS_WRITE,maz,(u16)psize))
					   {
					   	formaterror=1; //nepodaril se zapis
						break;
					   }
					   maz+=psize;
					  }
					 }
					}
					
					//predchysta hodnoty 0xff nebo 0x00 v navratovem sektoru (co vraci povel format)
					//a v pripade chyby nastavi FLAGS_WRITEERROR
					{
					 u08 *ptr;
					 ptr=atari_sector_buffer;
					 i=size;
					 do { *ptr++=0xff; i--; } while(i>0);
					 if (formaterror)
					 {
					  atari_sector_buffer[0]=0x00; //err
					  atari_sector_buffer[1]=0x00; //err
					  FileInfo.vDisk.flags |= FLAGS_WRITEERROR;	//nastavi FLAGS_WRITEERROR
					 }
					}

					//vrati je Atarku

					USART_Send_cmpl_and_atari_sector_buffer_and_check_sum(size);
					goto ST_IDLE; //aby nepokracoval
				}
				break;

			case 0x22: // format medium
				// 	Formats medium density on an Atari 1050. Format medium density cannot be achieved via PERCOM block settings!

				if ( (FileInfo.vDisk.flags & (FLAGS_ATRMEDIUMSIZE | FLAGS_READONLY) ) != FLAGS_ATRMEDIUMSIZE )
				{
					//FileInfo.percomstate=0;
					//goto Send_ERR_and_Delay;
Send_NACK_and_set_FLAGS_WRITEERROR_and_ST_IDLE:
					FileInfo.vDisk.flags |= FLAGS_WRITEERROR;	//nastavi FLAGS_WRITEERROR
					goto Send_NACK_and_ST_IDLE;
				}

				goto format_medium;
			   } //konec sekce pres dva case, 0x21,0x22
			   break;

		   case 0x50: //(write)
		   case 0x57: //(write verify)
		   		//pro tyhle commandy nerozina LED_GREEN_ON !
		   		goto device_command_accepted;

		   default:
				//pro vsechny ostatni rozina zelenou LED
   				LED_GREEN_ON;	// LED on

			}
			//je to nejaky jiny nez podporovany command?
			if(
			     (command[1]!=0x52) 
				 //&& (command[1]!=0x50) //uz porovnano predtimto (switch), skace na device_command_accepted;
				 && (command[1]!=0x53) 
				 //&& (command[1]!=0x57) //uz porovnano predtimto (switch), skace na device_command_accepted;
				 //&& (command[1]!=0x3f) //zpracovava se uvnitr teto podminky
				 && (command[1]!=0x4e) && (command[1]!=0x4f)
				 //&& (command[1]!=0x21) && (command[1]!=0x22) //uz zpracovany predtimto
			  )
			{
				if (command[1]==0x3f && fastsio_pokeydiv!=US_POKEY_DIV_STANDARD) goto device_command_accepted;
Send_NACK_and_ST_IDLE:
				send_NACK();
				goto ST_IDLE;
			}
device_command_accepted:

			send_ACK();
//			Delay1000us();	//delay_us(COMMAND_DELAY);

			switch(command[1])
			{

			case 0x3f:	// read speed index
				{
					atari_sector_buffer[0]=fastsio_pokeydiv;	//primo vraci Pokey divisor
					USART_Send_cmpl_and_atari_sector_buffer_and_check_sum(1);
					/*
					Delay800us();	//t5
					send_CMPL();
					//Delay800us();	//t6 <-- tohle tady nefungovalo, na Fast neslo bootnout ani pod Qmegem4
					Delay200us();
					USART_Transmit_Byte(pdiv);	//US_POKEY_DIV);
					Delay100usX(6);	//special 600us
					USART_Transmit_Byte(pdiv);	//US_POKEY_DIV);	// check_sum
					*/
					/*
					send_CMPL();
					Delay200us(); 	//delay_us(200); //delay_us(COMMAND_DELAY); doesn't work in Qmeg 3.2!
					USART_Transmit_Byte(US_POKEY_DIV);
					USART_Transmit_Byte(US_POKEY_DIV);	// check_sum
					*/
				}
				break;

			case 0x4e:	// read cfg (PERCOM)

/*
     byte 0:    Tracks per side (0x01 for HDD, one "long" track)
     byte 1:    Interface version (0x10)
     byte 2:    Sectors/Track - high byte
     byte 3:    Sectors/Track - low byte
     byte 4:    Side Code (0 - single sided)
     byte 5:    Record method (0=FM, 4=MFM double)
     byte 6:    High byte of Bytes/Sector (0x01 for double density)
     byte 7:    Low byte of Bytes/Sector (0x00 for double density)
     byte 8:    Translation control (0x40)
                  bit 6: Always 1 (to indicate drive present)
     bytes 9-11 Drive interface type string "IDE"
*/

/*
				atari_sector_buffer[0] = 40; //0x01; // HDD, one track
				atari_sector_buffer[1] =  0; //0x01; // version 0.1
				{
					unsigned long s;
					// 16 bytu za ATR neni potreba odecitat, nebot pri deleni 40 to vyjde stejne!
					s= FileInfo.vDisk.size / 40;
					if (FileInfo.vDisk.flags & FLAGS_ATRDOUBLESECTORS)
					 s=(s>>8)+1; //s=s/256; +1, protoze prvni 3 sektory jsou 128 a tudiz by se melo k size pripocitat 384 a to pak delit 40 a 256, ale vyjde nastejno pricist 1 k vyslednym sektorum
					else
					 s=(s>>7); //s=s/128;
					atari_sector_buffer[2] = (s>>8) & 0xff;   //hb sectors
					atari_sector_buffer[3] = ( s & 0xff ); //lb sectors
					atari_sector_buffer[4] = (s>>16) & 0xff; //pocet stran - 1  (0=> jedna strana)
				}
				//[5] =0 pro single, =4 pro mediumtype nebo doublesize sectors
				atari_sector_buffer[5] = (FileInfo.vDisk.flags & (FLAGS_ATRMEDIUMSIZE|FLAGS_ATRDOUBLESECTORS))? 0x04 : 0x00;
				if (FileInfo.vDisk.flags & FLAGS_ATRDOUBLESECTORS)
				{
					atari_sector_buffer[6]=0x01;	//sector size HB
					atari_sector_buffer[7]=0x00;	//sector size LB
				}
				else
				{
					atari_sector_buffer[6]=0x00;	//sector size HB
					atari_sector_buffer[7]=0x80;	//sector size LB
				}
				atari_sector_buffer[8]  = 0x01;	//0x01; //0x40; // drive exist
				atari_sector_buffer[9]  = 'S';	//0x41;	//0xc0; //'I'; 
				atari_sector_buffer[10] = 'D';	//0x00;	//0xf2; //'D'; 
				atari_sector_buffer[11] = 'r';	//0x00;	//0x42; //'E'; 
*/
				//XXXXXXXXXXXXXXXXXXXXXX
			{
				u08 *ptr;
				u08 isxex;
				u16 secsize;
				u32 fs;

				isxex = ( FileInfo.vDisk.flags & FLAGS_XEXLOADER );

				fs=FileInfo.vDisk.size;

				secsize=(FileInfo.vDisk.flags & FLAGS_ATRDOUBLESECTORS)? 0x100:0x80;
				
				ptr = system_percomtable;

				//if ( isxex ) ptr+=(IMSIZES*12);

				do
				{
				 u08 m;
				 //12 hodnot na radku v system_percomtable
				 //0x28,0x01,0x00,0x12,0x00,0x00,0x00,0x80, IMSIZE1&0xff,(IMSIZE1>>8)&0xff,(IMSIZE1>>16)&0xff,(IMSIZE1>>24)&0xff,
				 //...
				 //0x01,0x01,0x00,0x00,0x00,0x04,0x01,0x00, 0x00,0x00,0x00,0x00
				 for(m=0;m<12;m++) atari_sector_buffer[m]=eeprom_read_byte(ptr++);
				 if (    (!isxex) 
				 	  && ( FOURBYTESTOLONG(atari_sector_buffer+8)==(fs & 0xffffff80) )  // &0xff... kvuli vyruseni pripadnych 16bytu ATR hlavicky
					  && ( atari_sector_buffer[6]==(secsize>>8) ) //sectorsize hb
					)
				 {
				  //velikost souboru i sektoru souhlasi
				   goto percom_prepared;
				 }
				} while (atari_sector_buffer[0]!=0x01);

				//zadna znama disketa, nastavit velikost a pocet sektoru
				atari_sector_buffer[6]=(secsize>>8);	//hb
				atari_sector_buffer[7]=(secsize&0xff);	//db

 				if ( isxex )
				{
				 secsize=125; //-=3; //=125
				 fs+=(u32)46125;		//((u32)0x171*(u32)125);
				}
				if ( FileInfo.vDisk.flags & FLAGS_ATRDOUBLESECTORS )
				{
				 fs+=(u32)(3*128); //+384 bytu za prvni tri sektory s velikosti 128
				}

				//FOURBYTESTOLONG(atari_sector_buffer+8)=fs; //DEBUG !!!!!!!!!!!

				fs/=((u32)secsize); //prepocet filesize na pocet sektoru

				atari_sector_buffer[2] = ((fs>>8) & 0xff);	//hb sectors
				atari_sector_buffer[3] = (fs & 0xff );		//lb sectors
				atari_sector_buffer[4] = ((fs>>16) & 0xff);	//pocet stran - 1  (0=> jedna strana)

percom_prepared:
//*
				atari_sector_buffer[8]  = 0x01;	//0x01; //0x40; // drive exist
				atari_sector_buffer[9]  = 'S';	//0x41;	//0xc0; //'I'; 
				atari_sector_buffer[10] = 'D';	//0x00;	//0xf2; //'D'; 
				atari_sector_buffer[11] = 'r';	//0x00;	//0x42; //'E'; 
// */
			}

				USART_Send_cmpl_and_atari_sector_buffer_and_check_sum(12);

				break;


			case 0x4f:	// write cfg (PERCOM)

				if (USART_Get_atari_sector_buffer_and_check_and_send_ACK_or_NACK(12))
				{
					break;
				}

				//propocitam, zda velikost zapsana do percomu odpovida
				//velikosti vlozene diskety
				{
					u32 s;
					s = ((u32)atari_sector_buffer[0])
						 * ( (u32) ( (((u16)atari_sector_buffer[2])<<8) + ((u16)atari_sector_buffer[3]) ) )
						 * (((u32)atari_sector_buffer[4])+1)
						 * ( (u32) ( (((u16)atari_sector_buffer[6])<<8) + ((u16)atari_sector_buffer[7]) ) );
					if ( !(FileInfo.vDisk.flags & FLAGS_XFDTYPE) ) s+=16; //ATRko 16 bytu
					if ( FileInfo.vDisk.flags & FLAGS_ATRDOUBLESECTORS ) s-=384;	//prvni 3 sektory v double jsou jen 128bytu => odpocitat 3*128
					if (s!=FileInfo.vDisk.size)
					{
						FileInfo.percomstate=3;	//percom write bad
						//goto Send_ERR_and_Delay;
						goto Send_CMPL_and_Delay; //percom zapis je ok, ale hodnoty neodpovidaji
					}
				}

				FileInfo.percomstate=1;		//ok
				if ( (atari_sector_buffer[6]|atari_sector_buffer[7])==0x01) FileInfo.percomstate++; //=2 ok (double)

				goto Send_CMPL_and_Delay;
				break;


			case 0x50:	//write
			case 0x57:	//write (verify)
			case 0x52:	//read
				{
				unsigned short proceeded_bytes;
				unsigned short atari_sector_size;
				u32 n_data_offset;
				u16 n_sector;
				u16 file_sectors;

				FileInfo.percomstate=0;

				n_sector = TWOBYTESTOWORD(command+2);	//2,3

				if(n_sector==0)
					goto Send_ERR_and_Delay;

				if( !(FileInfo.vDisk.flags & FLAGS_XEXLOADER) )
				{
					//ATRko nebo XFDcko
					if(n_sector<4)
					{
						//sektory 1 az 3
						atari_sector_size = (unsigned short)0x80;	//128
						//optimalizace: n_sector = 1 az 3 a sector size je napevno 128!
						//stary zpusob: n_data_offset = (u32) ( ((u32)(((u32)n_sector)-1) ) * ((u32)atari_sector_size));
						n_data_offset = (u32) ( (n_sector-1) << 7 ); //*128;
					}
					else
					{
						//sektor 4 nebo dalsi
						atari_sector_size = (FileInfo.vDisk.flags & FLAGS_ATRDOUBLESECTORS)? ((unsigned short)0x100):((unsigned short)0x80);	//FileInfo.vDisk.atr_sector_size;
						n_data_offset = (u32) ( ((u32)(((u32)n_sector)-4) ) * ((u32)atari_sector_size)) + ((u32)384);
					}

					//ATR nebo XFD?
					if (! (FileInfo.vDisk.flags & FLAGS_XFDTYPE) ) n_data_offset+= (u32)16; //ATR header;

					if(command[1]==0x52)
					{
						//read
						proceeded_bytes = faccess_offset(FILE_ACCESS_READ,n_data_offset,atari_sector_size);
						if(proceeded_bytes==0)
						{
							goto Send_ERR_and_Delay;
						}
					}
					else
					{
						//write do image
						if (USART_Get_atari_sector_buffer_and_check_and_send_ACK_or_NACK(atari_sector_size))
						{
							break;
						}

						if ( get_readonly() || (FileInfo.vDisk.flags & FLAGS_READONLY) )
							 goto Send_ERR_and_Delay; //READ ONLY

						proceeded_bytes = faccess_offset(FILE_ACCESS_WRITE,n_data_offset,atari_sector_size);
						if(proceeded_bytes==0)
						{
							goto Send_ERR_and_Delay;
						}

						goto Send_CMPL_and_Delay;

					}
					//atari_sector_size= (bud 128 nebo 256 bytu)
				}
				else
				{
					//XEX
#define	XEX_SECTOR_SIZE	128

					if (command[1]!=0x52)
					{
						//snaha o zapis do XEXu
						//prebere data
						if (USART_Get_atari_sector_buffer_and_check_and_send_ACK_or_NACK(XEX_SECTOR_SIZE))
						{
							//neslouhlasil chcecksum (poslal uz NACK)
							break;
						}
						//a vrati error
						//protoze do XEXu zapisovat nejde (beee, beee... ;-)))
						goto Send_ERR_and_Delay;
					}

					//promaze buffer
					Clear_atari_sector_buffer(XEX_SECTOR_SIZE);

					if(n_sector<=2)		//n_sector>0 && //==0 se overuje hned na zacatku
					{
						//sektory xex bootloaderu, tj. 1 nebo 2
						u08 i,b;
						u08 *spt, *dpt;
						spt= &boot_xex_loader[(u16)(n_sector-1)*((u16)XEX_SECTOR_SIZE)];
						dpt= atari_sector_buffer;
						i=XEX_SECTOR_SIZE;
						do 
						{
						 b=eeprom_read_byte(spt++);
 						 //relokace bootloaderu z $0700 na jine misto
						 if (b==0x07) b+=bootloader_relocation;
						 *dpt++=b;
						 i--;
						} while(i);
					}

					//file_sectors se pouzije pro sektory $168 i $169 (optimalizace)
					//zarovnano nahoru, tj. =(size+124)/125
					file_sectors = ((FileInfo.vDisk.size+(u32)(XEX_SECTOR_SIZE-3-1))/((u32)XEX_SECTOR_SIZE-3));

					if(n_sector==0x168)
					{
						atari_sector_buffer[0]=2;	//status diskety 20101122
						//vrati pocet sektoru diskety
						//byty 1,2
						goto set_number_of_sectors_to_buffer_1_2;
					}
					else
					if(n_sector==0x169)
					{
						//fatGetDirEntry(FileInfo.vDisk.file_index,5,0);
						fatGetDirEntry(FileInfo.vDisk.file_index,0); //ale musi to posunout o 5 bajtu doprava
			
						{
							u08 i,j;
							for(i=j=0;i<8+3;i++)
							{
								if( ((atari_sector_buffer[i]>='A' && atari_sector_buffer[i]<='Z') ||
									(atari_sector_buffer[i]>='0' && atari_sector_buffer[i]<='9')) )
								{
								  //znak je pouzitelny na Atari
								  atari_sector_buffer[j]=atari_sector_buffer[i];
								  j++;
								}
								if ( (i==7) || (i==8+2) )
								{
									for(;j<=i;j++) atari_sector_buffer[j]=' ';
								}
							}
							//posune nazev z 0-10 na 5-15 (0-4 budou systemova adresarova data)
							//musi pozpatku
							for(i=15;i>=5;i--) atari_sector_buffer[i]=atari_sector_buffer[i-5];
							//a pak uklidi cely zbytek tohoto sektoru
							for(i=5+8+3;i<XEX_SECTOR_SIZE;i++)
								atari_sector_buffer[i]=0x00;
						}
						//teprve ted muze pridat prvnich 5 bytu na zacatek nulte adresarove polozky (pred nazev)
						//atari_sector_buffer[0]=0x42;							//0
						//jestlize soubor zasahuje do sektoru cislo 1024 a vic,
						//status souboru je $46 misto standardniho $42
						atari_sector_buffer[0]=(file_sectors>(0x400-0x171))? 0x46 : 0x42; //0

						TWOBYTESTOWORD(atari_sector_buffer+3)=0x0171;			//3,4
set_number_of_sectors_to_buffer_1_2:
						TWOBYTESTOWORD(atari_sector_buffer+1)=file_sectors;		//1,2
					}
					else
					if(n_sector>=0x171)
					{
						proceeded_bytes = faccess_offset(FILE_ACCESS_READ,((u32)n_sector-0x171)*((u32)XEX_SECTOR_SIZE-3),XEX_SECTOR_SIZE-3);

						if(proceeded_bytes<(XEX_SECTOR_SIZE-3))
							n_sector=0; //je to posledni sektor
						else
							n_sector++; //ukazatel na dalsi

						atari_sector_buffer[XEX_SECTOR_SIZE-3]=((n_sector)>>8); //nejdriv HB !!!
						atari_sector_buffer[XEX_SECTOR_SIZE-2]=((n_sector)&0xff); //pak DB!!! (je to HB,DB)
						atari_sector_buffer[XEX_SECTOR_SIZE-1]=proceeded_bytes;
					}

					//sector size vzdy 128 bytu
					atari_sector_size=XEX_SECTOR_SIZE;
				}

				//posle bud 128 nebo 256 (atr/xfd) nebo 128 (xex)
				USART_Send_cmpl_and_atari_sector_buffer_and_check_sum(atari_sector_size);

				}
				break;

			case 0x53:	//get status

				//FileInfo.percomstate=0;	//Hias

				atari_sector_buffer[0] = 0x10;	//0x00 motor off	0x10 motor on
				if (FileInfo.vDisk.flags & FLAGS_ATRMEDIUMSIZE) atari_sector_buffer[0]|=0x80;		//(FileInfo.vDisk.atr_medium_size);	// medium/single
				if (FileInfo.vDisk.flags & FLAGS_ATRDOUBLESECTORS) atari_sector_buffer[0]|=0x20;	//((FileInfo.vDisk.atr_sector_size==256)?0x20:0x00); //	double/normal sector size
				if (FileInfo.vDisk.flags & FLAGS_WRITEERROR)
				{
				 atari_sector_buffer[0]|=0x04;			//Write error status bit
				 //vynuluje FLAGS_WRITEERROR bit
				 FileInfo.vDisk.flags &= (~FLAGS_WRITEERROR);
				}
				if ( get_readonly() || (FileInfo.vDisk.flags & FLAGS_READONLY) ) atari_sector_buffer[0]|=0x08;	//write protected bit

				atari_sector_buffer[1] = 0xff;
				atari_sector_buffer[2] = 0xe0; 		//(244s) timeout pro nejdelsi operaci
				atari_sector_buffer[3] = 0x00;		//timeout hb

				USART_Send_cmpl_and_atari_sector_buffer_and_check_sum(4);

				break;
			} //switch
		} // disketove operace
		else
		if( command[0] == (unsigned char)0x71+3-((unsigned char)(inb(PINB))&0x03) )
		{
			// SDRIVE OPERACE 

			//if ( command[1]==0x50 || command[1]==0x52 || command[1]==0x53)
			if ( command[1]<=0x53 && command[1]>=0x50 )	//schvalne prehozeno poradi kvuli rychlosti (pri normalnich operacich s SDrive nebude platit hned prvni cast podminky)
			{
				//(0x50,x52,0x53)
				//pro povely readsector,writesector a status
				//pristup na D0: pres SDrive zarizeni 0x71-0x74
				command[0]=0x30;	//zmeni pozadovane zarizeni na D0:
				goto disk_operations_direct_d0_d4; //vzdy napevno vD0: bez prehazovani
			}


			send_ACK();
//			Delay1000us();	//delay_us(COMMAND_DELAY);

			if ( last_used_virtual_drive != 0x0f )
			{
				//predtim pracoval s nejakym Dx:
				//musi uschovat jeho stav do vDisk[]
				if ( last_used_virtual_drive < DEVICESNUM )
				{
				 unsigned char i;
				 unsigned char *p1;
				 unsigned char *p2;
				 p2=((unsigned char *)&FileInfo.vDisk);
				 p1=((unsigned char *)&vDisk[last_used_virtual_drive]);
				 // vDisk[last_used_virtual_drive] <- vDisk
				 //for(i=0; i<sizeof(virtual_disk_t); i++) p1[i]=p2[i];
				 for(i=0; i<sizeof(virtual_disk_t); i++) *p1++=*p2++;
				}
				//zmena last_used_virtual_drive
				last_used_virtual_drive=0x0f; //zmena
			}


			switch(command[1])
			{
/*
			case 0xXX:
				{
				 unsigned char* p = 0x060;
				 //check_sum = get_checksum(p,1024);	//nema smysl - checksum cele pameti by se ukladal zase do pameti a tim by to zneplatnil
				 Delay800us();	//t5
				 send_CMPL();
				 Delay800us();	//t6

				 USART_Send_Buffer(p,1024);
				 //USART_Transmit_Byte(check_sum);
				}
				break;

			case 0xXX:	//STACK POINTER+DEBUG_ENDOFVARIABLES
				{
				 Clear_atari_sector_buffer_256();
				 atari_sector_buffer[0]= SPL;	//inb(0x3d);
				 atari_sector_buffer[1]= SPH;	//inb(0x3e);
				 *((u32*)&(atari_sector_buffer[2]))=debug_endofvariables;

				 //check_sum = get_checksum(atari_sector_buffer,256);
				 //send_CMPL();
				 //Delay1000us();	//delay_us(COMMAND_DELAY);
				 //USART_Send_Buffer(atari_sector_buffer,256);
				 //USART_Transmit_Byte(check_sum);
 				 USART_Send_cmpl_and_atari_sector_buffer_and_check_sum(6);
				}
				break;

			case 0xXX:	//$XX nn mm	 config EEPROM par mm = value nn
				{
					eeprom_write_byte((&system_atr_name)+command[3],command[2]);
					goto Send_CMPL_and_Delay;
				}
				break;
*/

			//--------------------------------------------------------------------------

			case 0xC0:	//$C0 xl xh	Get 20 filenames from xhxl. 8.3 + attribute (11+1)*20+1 [<241]
						//		+1st byte of filename 21 (+1)
				{
					u08 i,j;
					u08 *spt,*dpt;
					u16 fidx;
					Clear_atari_sector_buffer_256();
					fidx=TWOBYTESTOWORD(command+2); //command[2],[3]
					dpt=atari_sector_buffer+12;
					i=21;
					while(1)
					{	
						i--;
						if (!fatGetDirEntry(fidx++,0)) break;
						//8+3+ukonceni0
						spt=atari_sector_buffer;
						if (!i)
						{
							*dpt++=*spt; //prvni znak jmena 21 souboru
							break;
						}
					 	j=11; //8+3znaku=11
						do { *dpt++=*spt++; j--; } while(j);
						*dpt++=FileInfo.Attr; //na pozici[11] da atribut
					}// while(i);
					//a ted posunout 241 bajtu o 12 dolu [12-252] => [0-240]
					spt=atari_sector_buffer+12;
					dpt=atari_sector_buffer;
					i=241;
					do { *dpt++=*spt++; i--; } while(i);
					USART_Send_cmpl_and_atari_sector_buffer_and_check_sum(241); //241! bajtu
				}
				break;


			case 0xC1:	//$C1 nn ??	set fastsio pokey divisor
				
				if (command[2]>US_POKEY_DIV_MAX) goto Send_ERR_and_Delay;
				fastsio_pokeydiv = command[2];
				fastsio_active=0;	//zmenila se rychlost, musi prejit na standardni
				
				/*
				//takhle to zlobilo
				//vzdy to zabrucelo a vratio error #$8a (i kdyz se to provedlo)
				USART_Init(ATARI_SPEED_STANDARD); //a zinicializovat standardni
				goto Send_CMPL_and_Delay;
				*/

				Delay800us();	//t5
				send_CMPL();
				goto change_sio_speed_by_fastsio_active;
				//USART_Init(ATARI_SPEED_STANDARD); //a zinicializovat standardni
				//break;


			case 0xC2:	//$C2 nn ??	set bootloader relocation = $0700+$nn00

				bootloader_relocation = command[2];
				goto Send_CMPL_and_Delay;

			//--------------------------------------------------------------------------

			case 0xDA:	//get system values
				{
					u08 *sptr,*dptr;
					u08 i;
					dptr=atari_sector_buffer;
					//
					//Globalni sada promennych
					sptr=(u08*)&GS;
					i=sizeof(struct GlobalSystemValues);	//13
					do { *dptr++=*sptr++; i--; } while(i>0);
					//tzv. lokalni vDisk
					sptr=(u08*)&FileInfo.vDisk;
					i=sizeof(virtual_disk_t);				//15
					do { *dptr++=*sptr++; i--; } while(i>0);

					//celkem 26 bytu
					USART_Send_cmpl_and_atari_sector_buffer_and_check_sum( (sizeof(struct GlobalSystemValues)+sizeof(virtual_disk_t)) );
				}				
				break;

			case 0xDB:	//get vDisk flag [<1]
				{
					//atari_sector_buffer[0] = (command[2]<DEVICESNUM)? GetvDiskPtr(command[2])->flags : FileInfo.vDisk.flags;
					atari_sector_buffer[0] = FileInfo.vDisk.flags;
					USART_Send_cmpl_and_atari_sector_buffer_and_check_sum(1);
				}
				break;

			case 0xDC:	//$DC xl xh	fatClusterToSector xl xh [<4]
				{
					FOURBYTESTOLONG(atari_sector_buffer) = fatClustToSect(TWOBYTESTOWORD(command+2));
					USART_Send_cmpl_and_atari_sector_buffer_and_check_sum(4);
				}
				break;

			case 0xDD:	//set SDsector number

				if (USART_Get_atari_sector_buffer_and_check_and_send_ACK_or_NACK(4))
				{
					break;
				}

				extraSDcommands_readwritesectornumber = *((u32*)&atari_sector_buffer);

				//uz si to hned ted nacte do cache kvuli operaci write SDsector
				//ve ktere Atarko zacne posilat data brzo po ACKu a nemuselo by se to stihat
				mmcReadCached(extraSDcommands_readwritesectornumber);

				goto Send_CMPL_and_Delay;
				break;

			case 0xDE:	//read SDsector

				mmcReadCached(extraSDcommands_readwritesectornumber);

				Delay800us();	//t5
				send_CMPL();
				Delay800us();	//t6
				{
				 u08 check_sum;
				 check_sum = get_checksum(mmc_sector_buffer,512);
				 USART_Send_Buffer(mmc_sector_buffer,512);
				 USART_Transmit_Byte(check_sum);
				}
				//USART_Send_cmpl_and_atari_sector_buffer_and_check_sum(atari_sector_size); //nelze pouzit protoze checksum je 513. byte (prelezl by ven z bufferu)
				break;

			case 0xDF:	//write SDsector
				
				//Specificky problem:
				//Atarko zacina predavat data za t3(min)=1000us,
				//ale tak rychle nestihneme nacist (Flushnout) mmcReadCached
				//RESENI => mmcReadCached(extraSDcommands_readwritesectornumber);
				//          se vola uz pri nastavovani cisla SD sektoru, takze uz je to
				//          nachystane. (tedy pokud si nezneplatnil cache jinymi operacemi!)
			
				//nacte ho do mmc_sector_bufferu
				//tim se i Flushne pripadny odlozeny write
				//a nastavi se n_actual_mmc_sector
				mmcReadCached(extraSDcommands_readwritesectornumber);

				//prepise mmc_buffer daty z Atarka
				{
				 u08 err;
				 err=USART_Get_Buffer_And_Check(mmc_sector_buffer,512,CMD_STATE_H);
				 Delay1000us();
				 if(err)
				 {
					//obnovi puvodni stav mc_sector_bufferu z SDkarty!!!
					mmcReadCached(extraSDcommands_readwritesectornumber);
					send_NACK();
					break;
				 }
				}

				send_ACK();

				//zapise zmenena data v mmc_sector_bufferu do prislusneho SD sektoru
				if (mmcWriteCached(0)) //klidne s odlozenym zapisem
				{
					goto Send_ERR_and_Delay; //nepovedlo se (zakazany zapis)
				}

				goto Send_CMPL_and_Delay;
				break;

			//--------------------------------------------------------------------------

			case 0xE0: //get status
				//$E0  n ??	Get status. n=bytes of infostring "SDriveVV YYYYMMDD..."

				if (!command[2]) goto Send_CMPL_and_Delay;

				{
				 u08 i;
				 for(i=0; i<command[2]; i++) atari_sector_buffer[i]=eeprom_read_byte(&system_info[i]);
				}

				USART_Send_cmpl_and_atari_sector_buffer_and_check_sum(command[2]);

				break;


			case 0xE1: //init drive
				//$E1  n ??	Init drive. n=0 (komplet , jako sdcardejected), n<>0 (jen setbootdrive d0: bez zmeny actual drive)

				//protoze muze volat prvni cast s mmcReset,
				//musi ulozit pripadny nacacheovany sektor
			 	mmcWriteCachedFlush(); //pokud ceka nejaky sektor na zapis, zapise ho

				Delay800us();	//t5
				send_CMPL();
				
				if ( command[2]==0 ) goto SD_CARD_EJECTED;
				//goto SET_BOOT_DRIVE; //<--tohle zmeni i actual_drive na 0
				goto SET_SDRIVEATR_TO_D0; //bez zmeny actual_drive
				break;


			case 0xE2: //$E2  n ??	Deactivation of device Dn:
				if ( command[2] >= DEVICESNUM ) goto Send_ERR_and_Delay;
				GetvDiskPtr(command[2])->flags &= ~FLAGS_DRIVEON; //vDisk[command[2]].flags &= ~FLAGS_DRIVEON;
				goto Send_CMPL_and_Delay;
				break;

			case 0xE3: //$E3  n ??	Set actual directory by device Dn: and get filename. 8.3 + attribute + fileindex [11+1+2=14]
			   {
				unsigned char *p1;
				unsigned char *p2;
				unsigned char i;
				if ( command[2] >= DEVICESNUM) goto Send_ERR_and_Delay;
				//if (!(vDisk[command[2]].flags & FLAGS_DRIVEON))
				if (!(GetvDiskPtr(command[2])->flags & FLAGS_DRIVEON))
				{
					//v teto jednotce neni nic, takze vrati 14 bytu prazdny buffer
					//a NEBUDE menit adresar!

Command_FD_E3_empty:	//sem skoci z commandu FD kdyz chce vratit
						//prazdnych 14 bytu jakoze neuspesny vysledek misto nalezeneho
						//fname 8+3+atribut+fileindex, tj. jako command E3

Command_ED_notfound:	//sem skoci z commandu ED kdyz nenajde hledany nazev souboru
						//vraci 14 prazdnych bytu jakoze neuspesny vysledek

					Clear_atari_sector_buffer(14);

					USART_Send_cmpl_and_atari_sector_buffer_and_check_sum(14);
					break;
				}
				p1=((unsigned char *)&FileInfo.vDisk);
				p2=((unsigned char *)&vDisk[ command[2] ]);
				// vDisk <- vDisk[ command[2] ]
				for(i=0; i<sizeof(virtual_disk_t); i++) p1[i]=p2[i];
			   }

				// VOLANI GET DETAILED FILENAME
				command[2]=(unsigned char)(FileInfo.vDisk.file_index & 0xff);
				command[3]=(unsigned char)(FileInfo.vDisk.file_index >> 8);

				// a pokracuje dal!!!

			case 0xE4: 	//$E4 xl xh	Get filename xhxl. 8.3 + attribute [11+1=12]
			case 0xE5:	//$E5 xl xh	Get more detailed filename xhxl. 8.3 + attribute + size/date/time [11+1+8=20]
			   {
				unsigned char ret,len;
				//ret=fatGetDirEntry((command[2]+(command[3]<<8)),0);
				ret=fatGetDirEntry(TWOBYTESTOWORD(command+2),0);

				if (0)
				{
Command_FD_E3_ok:	//sem skoci z commandu FD kdyz chce vratit
					//fname 8+3+atribut+fileindex, tj. stejne jako vraci command E3
Command_ED_found:	//sem skoci z commandu ED kdyz najde hledane filename a chce vratit
					//fname 8+3+atribut+fileindex, tj. stejne jako vraci command E3
					command[1]=0xE3;
					ret=1;
				}

				atari_sector_buffer[11]=(unsigned char)FileInfo.Attr;
				if (command[1] == 0xE3)
				{
					//command 0xE3
					/*
					atari_sector_buffer[12]=(unsigned char)(FileInfo.vDisk.file_index&0xff);
					atari_sector_buffer[13]=(unsigned char)(FileInfo.vDisk.file_index>>8);
					*/
					TWOBYTESTOWORD(atari_sector_buffer+12)=FileInfo.vDisk.file_index; //12,13
					len=14;
				}
				else
				if (command[1] == 0xE5)
				{
					unsigned char i;
					//command 0xE5
					/*
					atari_sector_buffer[12]=(unsigned char)(FileInfo.vDisk.Size&0xff);
					atari_sector_buffer[13]=(unsigned char)(FileInfo.vDisk.Size>>8);
					atari_sector_buffer[14]=(unsigned char)(FileInfo.vDisk.Size>>16);
					atari_sector_buffer[15]=(unsigned char)(FileInfo.vDisk.Size>>24);
					*/
					FOURBYTESTOLONG(atari_sector_buffer+12)=FileInfo.vDisk.size; //12,13,14,15
					//atari_sector_buffer[16]=(unsigned char)(FileInfo.Date&0xff);
					//atari_sector_buffer[17]=(unsigned char)(FileInfo.Date>>8);
					TWOBYTESTOWORD(atari_sector_buffer+16)=FileInfo.Date; //16,17
					//atari_sector_buffer[18]=(unsigned char)(FileInfo.Time&0xff);
					//atari_sector_buffer[19]=(unsigned char)(FileInfo.Time>>8);
					TWOBYTESTOWORD(atari_sector_buffer+18)=FileInfo.Time; //18,19

					//1234567890 YYYY-MM-DD HH:MM:SS
					//20-49
					//20-29 string decimal size
					for(i=20; i<=49; i++) atari_sector_buffer[i]=' ';
					{
					 unsigned long size=FileInfo.vDisk.size;
					 if ( !(FileInfo.Attr & (ATTR_DIRECTORY|ATTR_VOLUME)) )
					 {
					 	//pokud to neni directory nebo nazev disku (volume to ani nemuze byt - getFatDirEntry VOLUME vynechava)
						//zapise na posledni pozici "0" (jakoze velikost souboru = 0 bytes)
						//(bud ji nasledne prepise skutecnou velikosti, nebo tam zustane)
						atari_sector_buffer[29]='0';
					 }
					 for(i=29; (i>=20); i--)
					 {
					  if (size) //>0
					  {
					   atari_sector_buffer[i]= 0x30 | ( size % 10 );	//cislice '0'-'9'
					   size/=10;
					  }
					 }
				    }
//					atari_sector_buffer[32]=' '; //je promazane ve smycce predtim
//					atari_sector_buffer[43]=' '; //je promazane ve smycce predtim
					//33-42 string date YYYY-MM-DD
					atari_sector_buffer[35]='-';
					atari_sector_buffer[38]='-';
					//44-51 string time HH:MM:SS
					atari_sector_buffer[44]=':';
					atari_sector_buffer[47]=':';
					{
					 unsigned short d;
					 //date
					 d=(FileInfo.Date>>9)+1980;
					 PutDecimalNumberToAtariSectorBuffer(d/100,31);
					 PutDecimalNumberToAtariSectorBuffer(d%100,33);
					 //
					 PutDecimalNumberToAtariSectorBuffer((FileInfo.Date>>5)&0x0f,36);
					 //atari_sector_buffer[36]=0x30|(d/10);
					 //atari_sector_buffer[37]=0x30|(d%10);
					 PutDecimalNumberToAtariSectorBuffer((FileInfo.Date)&0x1f,39);
					 //atari_sector_buffer[39]=0x30|(d/10);
					 //atari_sector_buffer[40]=0x30|(d%10);
					 //time
					 PutDecimalNumberToAtariSectorBuffer((FileInfo.Time>>11),42);
					 //atari_sector_buffer[42]=0x30|(d/10);
					 //atari_sector_buffer[43]=0x30|(d%10);
					 PutDecimalNumberToAtariSectorBuffer((FileInfo.Time>>5)&0x3f,45);
					 //atari_sector_buffer[45]=0x30|(d/10);
					 //atari_sector_buffer[46]=0x30|(d%10);
					 PutDecimalNumberToAtariSectorBuffer(((FileInfo.Time)&0x1f)<<1,48);	//doubleseconds
					 //atari_sector_buffer[48]=0x30|(d/10);
					 //atari_sector_buffer[49]=0x30|(d%10);
					}
					len=50;
				}
				else
					len=12;	//command 0xE4

				//pokud fatGetDirEntry neproslo, promaze buffer
				//(delka len musi zustat, aby posilal prazdny buffer prislusne delky)
				if (!ret)
				{
				 //50 je maximalni delka ze 12,14 a 50
				 //unsigned char i;
				 //for(i=0; i<50; i++) atari_sector_buffer[i]=0x00;	
 				 Clear_atari_sector_buffer(50);
				}

				USART_Send_cmpl_and_atari_sector_buffer_and_check_sum(len);
			   }
			   break;

			case 0xE6:	//$E6 xl xh	Get longfilename xhxl. [256]
			case 0xE7:
			case 0xE8:
			case 0xE9:
			   {
				unsigned short i;

				i=0;
				if (fatGetDirEntry(TWOBYTESTOWORD(command+2),1))
				{
				 //nasel, takze se posune i-ckem az na konec longname
				 while(atari_sector_buffer[i++]!=0);	//!!!!!!!!!!!!!!!!! pokud by longname melo 256 znaku, zasekne se to tady!!! Bacha!!!
				}
				while(i<256) atari_sector_buffer[i++]=0x00; //smaze zbytek

				//jakou delku chce z Atarka prebirat?
				i=(0x0100>>(command[1]-0xE6)); //=256,128,64,32

				USART_Send_cmpl_and_atari_sector_buffer_and_check_sum(i);
			   }
			   break;

			case 0xEA:	//$EA ?? ??	Get number of items in actual directory [<2]
			   {
			   	unsigned short i;
				i=0;
				while (fatGetDirEntry(i,0)) i++;
				TWOBYTESTOWORD(atari_sector_buffer+0)=i;	//0,1
				USART_Send_cmpl_and_atari_sector_buffer_and_check_sum(2);
			   }
			   break;

			case 0xEB:	//$EB  n ??	GetPath (n=pocet updir skoku, if(n==0||n>20) n=20 )   [<n*12]  pro n==0 [<240]
						//         	Get path (/DIRECTOREXT/../DIRECTOREXT pokracuje 0x00) (nemeni aktualni adresar!)
         				//			Pokud je cesta do rootu delsi nez pozadovany pocet skoku, prvni znak je '?'
			   {
			     unsigned short ocluster, acluster;
				 unsigned char pdi;
				 u08 updirs;
				 if (command[2]==0 || command[2]>20) command[2]=20; //maximum [<240]
				 updirs=command[2]; //pocet updir skoku
				 pdi=0; //index do bufferu kam zapisuje podadresare
				 ocluster=FileInfo.vDisk.dir_cluster; //pro obnoveni na konec
				 while ( fatGetDirEntry(0,0) //0.polozka by mela byt ".." ("." se vynechava)		//fatGetDirEntry(1,0)
				 	  && (FileInfo.Attr & ATTR_DIRECTORY)
					  && atari_sector_buffer[0]=='.' && atari_sector_buffer[1]=='.' )
				 {
					if (!updirs)	//pocet updir skoku
					{
					 //uz udelal tolik updir skoku kolik chtel
					 //a protoze se tim jeste porad nedostal do rootu,
					 // cesta bude ?adresar1/adresar2
					 atari_sector_buffer[pdi]='?';
					 break;
					}
					updirs--;
					//Schova si cluster zacatku nynejsiho adresare
					acluster=FileInfo.vDisk.dir_cluster;
					//Meni adresar
					FileInfo.vDisk.dir_cluster=FileInfo.vDisk.start_cluster;
					//jde najit nazev opusteneho adresare a ulozi ho na konec bufferu "/8+3"
					unsigned short i;
					for(i=0; fatGetDirEntry(i,0); i++)
					{
						if (acluster==FileInfo.vDisk.start_cluster)
						{
						 //nasel ho, zkopiruje na konec bufferu
						 u08 *spt,*dpt;
						 u08 j;
						 pdi-=12;
						 spt=atari_sector_buffer;
						 dpt=atari_sector_buffer+pdi;
						 *dpt++='/';	//zacne '/'
						 j=11; do { *dpt++=*spt++; j--; } while(j); //pokracuje 11 znaku dirname
						 break;
						}
					}
				  }
				  //nastavi zpatky puvodni adresar
				  FileInfo.vDisk.dir_cluster=ocluster;
				  //posune nalezenou cestu na zacatek bufferu
				  {
				   unsigned short k;
				   unsigned char m;
				   for(k=pdi,m=0; k<256; k++,m++) atari_sector_buffer[m]=atari_sector_buffer[k];
				   if (!m) { atari_sector_buffer[0]=0; m++; }
				   for(; m!=0; m++) atari_sector_buffer[m]=0; //ukonceni+promaze zbytek bufferu
				  }
				  USART_Send_cmpl_and_atari_sector_buffer_and_check_sum(command[2]*12);
			    }
			 	break;

			case 0xEC: //$EC  n  m	Find filename 8+3.
			           //(Predava se vzor 11 bytu, nulove znaky jsou ignorovany).
					   // If (m<>0) set fileOrdirectory to vDn:

				//FileFindBuffer <> atari_sector_buffer !!!
				if (USART_Get_buffer_and_check_and_send_ACK_or_NACK(FileFindBuffer,11))
				{
					break;
				}

				if (!command[3]) goto Send_CMPL_and_Delay;

				//zmeni command na 0xf0-0xff (pro nastaveni nalezeneho souboru/adresare)				
				command[1]=(0xf0|command[2]);
				command[2]=command[3]=0; //vyhledavat od indexu 0
				//a pokracuje dal...
				//commandem ED...

			case 0xED: //$ED xl xh       Find filename (8+3) from xhxl index in actual directory, get filename 8.3+attribute+fileindex [11+1+2=14]

			    {
					unsigned short i;
					u08 j;

					i=TWOBYTESTOWORD(command+2);  //zacne hledat od tohoto indexu

					while(fatGetDirEntry(i,0))
					{
					 for(j=0; (j<11); j++)
					 {
					 	if (!FileFindBuffer[j]) continue; //znaky 0x00 ve vzoru ignoruje (mohou byt jakekoliv)
						if (FileFindBuffer[j]!=atari_sector_buffer[j]) goto Different_char; //rozdilny znak
					 }
					 //nalezeny nazev vyhovuje vzoru
					 if (command[1]>=0xf0)
					 {
					  //prisel sem z commandu EC (ktery ho nastavil na $f0-$ff)
					  //takze jde nastavit ten vyhledany soubor
					  goto Command_EC_F0_FF_found;
					 }
					 goto Command_ED_found;
Different_char:
					 i++;
					}

					//nenalezl zadny nazev vyhovujici vzoru

					if (command[1]>=0xf0)
					{
						//prisel sem z commandu EC (ktery ho nastavil na $f0-$ff)
						goto Send_ERR_and_Delay;
					}

					goto Command_ED_notfound;
				}
				break;

			case 0xEE:	//$EE  n ??	Swap vDn: (n=0..4) with D{SDrivenum}:  (if n>=5) Set default (all devices with relevant numbers).

				//Prepnuti prislusneho drive do Dsdrivenum:
				//(if >=5) SetDefault
				actual_drive_number = ( command[2] < DEVICESNUM )? command[2] : 4-((unsigned char)(inb(PINB))&0x03);
				set_display(actual_drive_number);
				goto Send_CMPL_and_Delay;
				break;

			case 0xEF:	//$EF  n  m	Get SDrive parameters (n=len, m=from) [<n]
				{
				 u08 *spt,*dpt;
				 u08 n;
				 n=command[2];
				 spt=((u08*)&sdrparams)+command[3];	//m
				 dpt=atari_sector_buffer;
				 do { *dpt++=*spt++; n--; } while(n);
				 USART_Send_cmpl_and_atari_sector_buffer_and_check_sum(command[2]);
				}
				break;

			case 0xFD:	//$FD  n ??	Change actual directory up (..). If n<>0 => get dirname. 8+3+attribute+fileindex [<14]
				 if (fatGetDirEntry(0,0))	//0.polozka by mela byt ".." ("." se vynechava)		//fatGetDirEntry(1,0)
				 {
					if ( (FileInfo.Attr & ATTR_DIRECTORY)
						&& atari_sector_buffer[0]=='.' && atari_sector_buffer[1]=='.')
					{
						//Schova si cluster zacatku nynejsiho adresare
						unsigned short acluster;
						acluster=FileInfo.vDisk.dir_cluster;
						//Meni adresar
						FileInfo.vDisk.dir_cluster=FileInfo.vDisk.start_cluster;
						//aux1 ?
						if (command[2])
						{
						 //chce vratit 8+3+atribut+fileindex
						 unsigned short i;
						 for(i=0; fatGetDirEntry(i,0); i++)
						 {
							if (acluster==FileInfo.vDisk.start_cluster)
							{
							 //skoci do casti predavani jmena 8+3+atribut+fileindex
							 goto Command_FD_E3_ok; //nasel ho!
							}
						 }
						 //nenasel ho vubec
						 //tohle nemusime resit, nebot to nikdy nemuze nastat!
						 //(znamenalo by to nekonzistentni FATku)
						 //tj. cluster z ".." by ukazoval na adresar ve kterem by nebyl adresar
						 //s clusterem ukazujicim na tento podadresar.
						}
					}
				 }
				 //nulta polozka neexistuje nebo neni ".."
				 //coz znamena ze jsme uz v rootu
				 if (command[2])
				 {
					  //chce vratit filename 8+3+atribut+fileindex
					  //takze musi dostat 14 prazdnych bajtu
					  //u08 i;
					  //for(i=0; i<14; i++) atari_sector_buffer[i]=0;
					  //USART_Send_cmpl_and_atari_sector_buffer_and_check_sum(14);
					  goto Command_FD_E3_empty;
				 }
				 goto Send_CMPL_and_Delay;
				 break;

			case 0xFE:	//$FE ?? ??	Change actual directory to rootdir.
				FileInfo.vDisk.dir_cluster=MSDOSFSROOT;
				fatGetDirEntry(0,0);
				goto Send_CMPL_and_Delay;
				break;

			case 0xF0:	// set direntry to vD0:
			case 0xF1:	// set direntry to vD1:
			case 0xF2:	// set direntry to vD2:
			case 0xF3:	// set direntry to vD3:
			case 0xF4:	// set direntry to vD4:
			case 0xFF:  // set actual directory
				{
				unsigned char ret;

				ret=fatGetDirEntry(TWOBYTESTOWORD(command+2),0); //2,3

				if(ret)
				{
Command_EC_F0_FF_found:
					if( (FileInfo.Attr & ATTR_DIRECTORY) )
					{
						//Meni adresar
						FileInfo.vDisk.dir_cluster=FileInfo.vDisk.start_cluster;
					}
					else
					{
						//Aktivuje soubor
						FileInfo.vDisk.current_cluster=FileInfo.vDisk.start_cluster;
						FileInfo.vDisk.ncluster=0;

						if( atari_sector_buffer[8]=='A' &&
							 atari_sector_buffer[9]=='T' &&
							  atari_sector_buffer[10]=='R' )
						{
							// ATR
							unsigned long compute;
							unsigned long tmp;

							faccess_offset(FILE_ACCESS_READ,0,16); //je to ATR
									
							FileInfo.vDisk.flags=FLAGS_DRIVEON;
							//FileInfo.vDisk.atr_sector_size = (atari_sector_buffer[4]+(atari_sector_buffer[5]<<8));
							if ( (atari_sector_buffer[4]|atari_sector_buffer[5])==0x01 )
								FileInfo.vDisk.flags|=FLAGS_ATRDOUBLESECTORS;

							compute = FileInfo.vDisk.size - 16;		//je to ATR
							tmp = (FileInfo.vDisk.flags & FLAGS_ATRDOUBLESECTORS)? 0x100:0x80;		//FileInfo.vDisk.atr_sector_size;
							compute /=tmp;
							if(compute>720) FileInfo.vDisk.flags|=FLAGS_ATRMEDIUMSIZE; //atr_medium_size = 0x80;
						}
						else
						if( atari_sector_buffer[8]=='X' &&
							 atari_sector_buffer[9]=='F' &&
							  atari_sector_buffer[10]=='D' )
						{
							//XFD
							FileInfo.vDisk.flags=(FLAGS_DRIVEON|FLAGS_XFDTYPE);
							//if ( FileInfo.vDisk.Size == 92160 ) //normal XFD
							if ( FileInfo.vDisk.size>92160)
							{
							 	if ( FileInfo.vDisk.size<=133120)
							 	{
									// Medium size
									FileInfo.vDisk.flags|=FLAGS_ATRMEDIUMSIZE;
							  	}
								else
								{
							   		// Double (FileInfo.vDisk.Size == 183936)
									FileInfo.vDisk.flags|=FLAGS_ATRDOUBLESECTORS;
							  	}
							}
						}
						else
						{
							// XEX
							FileInfo.vDisk.flags=FLAGS_DRIVEON|FLAGS_XEXLOADER|FLAGS_ATRMEDIUMSIZE|FLAGS_READONLY;
						}
					}

					ret=(command[1]&0x0f);	//0..f
					//0..DEVICESNUM ... nastaveni prislusneho vDx:
					//0x0f ... jen listovani adresari
					if (ret < DEVICESNUM )
					{
						//nastavi vD0: az vD4:
						unsigned char i;
						unsigned char *p1;
						unsigned char *p2;
						p1=((unsigned char *)&vDisk[ret]);
						p2=((unsigned char *)&FileInfo.vDisk);
						// vDisk[ret] <- vDisk
						//for(i=0; i<sizeof(virtual_disk_t); i++) p1[i]=p2[i];
						for(i=0; i<sizeof(virtual_disk_t); i++) *p1++=*p2++;
						//
					}

					goto Send_CMPL_and_Delay;
				}
				else
				{
					goto Send_ERR_and_Delay;
				}
				
				}
				break;

			default:
				goto Send_ERR_and_Delay;	//nerozpoznany SDrive command


			} //switch

			if (0)
			{
Send_CMPL_and_Delay:
				Delay800us();	//t5
				send_CMPL();
			}
			if (0)
			{
Send_ERR_and_Delay:
				Delay800us();	//t5
				send_ERR();
			}
			//za poslednim cmpl nebo err neni potreba pauza, jde hned cekat na command
		} //sdrive operations

	}

	return 0;
}
